logos-electromechanical/Zigduino-Hardware/README.md

Zigduino-Hardware
=================

Hardware repository for the Zigduino
