logos-electromechanical/Zigduino-Hardware/Micro/doc/zigduinomote-layout.png

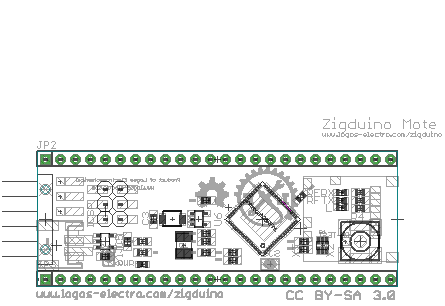
Micro/doc/zigduinomote-layout.png
