logos-electromechanical/Zigduino-Hardware/Micro/doc/zigduinomote-schematic.png

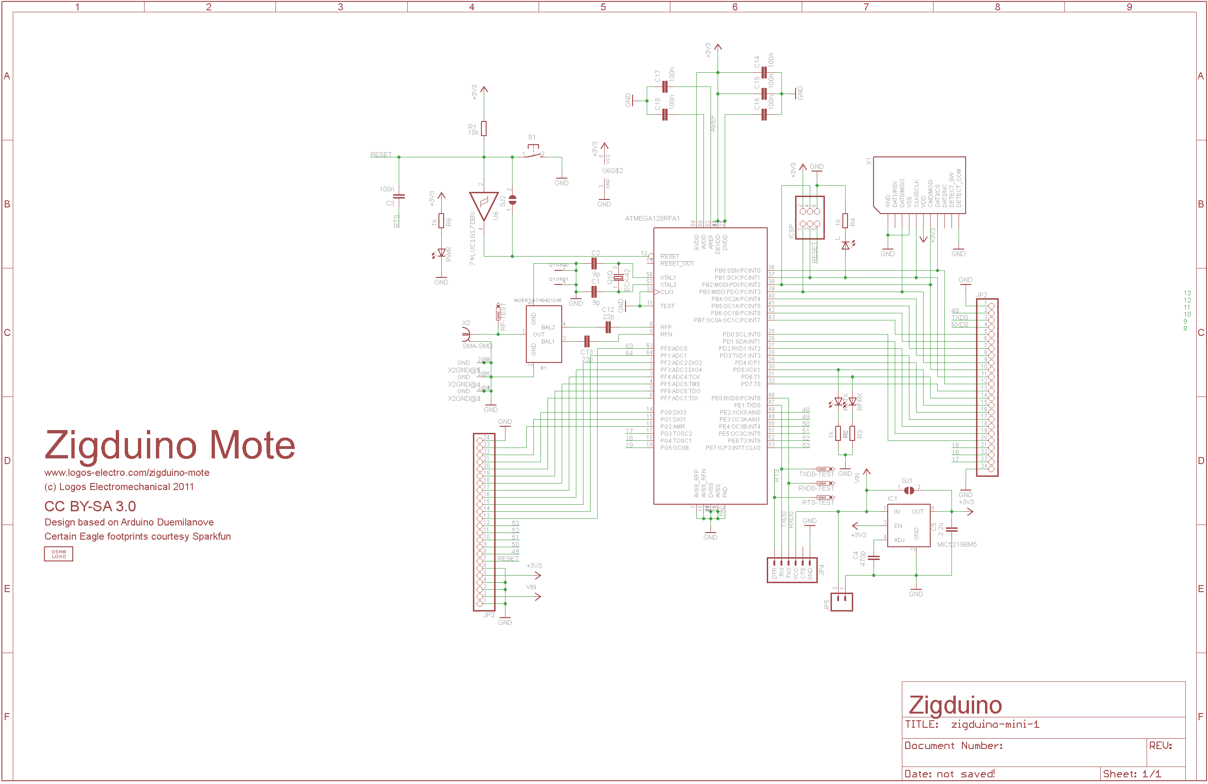
Micro/doc/zigduinomote-schematic.png
