logos-electromechanical/Zigduino-Hardware/Micro/zig-micro-bottom.png

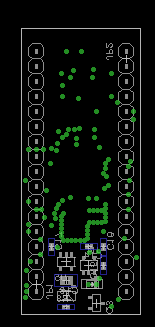
Micro/zig-micro-bottom.png
