logos-electromechanical/Zigduino-Hardware/Micro/zig-micro-schematic.png

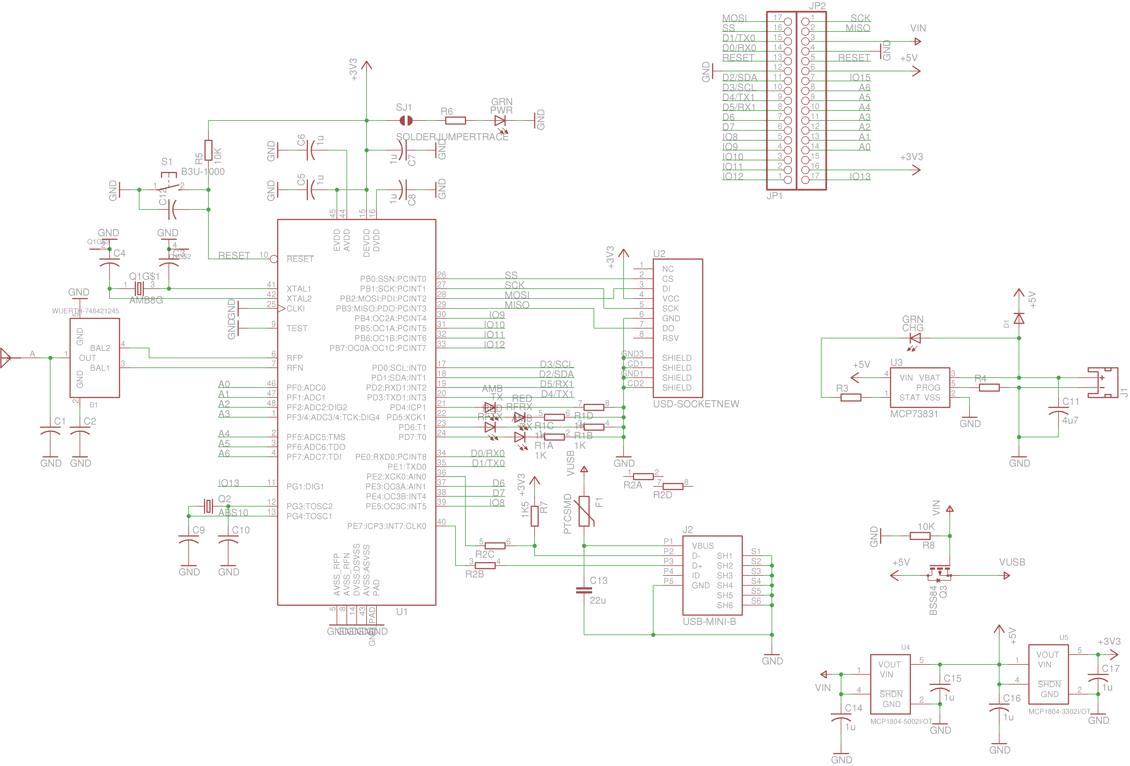
Micro/zig-micro-schematic.png
