logos-electromechanical/Zigduino-Hardware/Micro/zig-micro-top.png

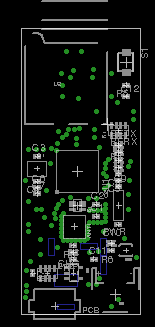
Micro/zig-micro-top.png
