logos-electromechanical/Zigduino-Hardware/Main/mfg/BoM/zigduino-v5_2011Aug-Build-Parts.xlsx

Sheet: Zigduino-v5 individual
Manufacturer Part Number | Description | Quantity Min | Part References | Populate?
742C083101JPTR | RES ARRAY 100 OHM 8TERM 4RES SMD | 6 | R12/R13/R14/R15/R16/R17 | Y
961206-6404-AR | CONN HEADER VERT DUAL 6POS GOLD | 1 | ICSP | DNP
1734035-2 | CONN MINI USB RCPT RA TYPE B SMD | 1 | USB | Y
748421245 | BALUN EMBER351 & 357 0805 SMD | 1 | B1 | Y
ATMEGA128RFA1-ZUR | IC AVR MCU 2.4GHZ XCEIVER 64QFN | 1 | U3 | Y
B3U-1000P | SWITCH TACT SPST W/O GND SMD | 1 | S1 | Y
B150B-13-F | DIODE SCHOTTKY 50V 1A SMB | 1 | D1 | Y
C1608C0G1H090C | CAP CER 9.0PF 50V C0G 0603 | 2 | C1/C2 | Y
C3216Y5V1H475Z | CAP CER 4.7UF 50V Y5V 1206 | 3 | C4/C5/C6 | Y
CC0603MRY5V9BB104 | CAP CERAMIC .1UF 50V Y5V 0603 | 11 | C3/C7/C8/C9/C10/C11/C14/C15/C16/C17/C18 | Y
CONREVSMA003.062 | RF Connectors RP-SMA Fml Edge Mnt for 0.062 Thick Brd | 1 | RF | DNP
ECS-160-9-42-CKM-TR | CRYSTAL 16.000 MHZ 9PF SMD | 1 | Q1 | Y
NTF5P03T3G | MOSFET P-CH 30V 3.7A SOT223 | 1 | T1 | Y
FT232RL-REEL | IC USB TO SERIAL UART 28-SSOP | 1 | U4 | Y
GQM1885C1H220JB01D | CAP CER 22PF 50V 5% C0G 0603 | 2 | C12/C13 | Y
LM358DR | IC OPAMP GP 700KHZ DUAL 8SOIC | 1 | U5 | Y
LTST-C193KGKT-5A | LED GREEN RECT CLEAR 0603 | 2 | L/PWR | Y
LTST-C193KRKT-5A | LED RED RECT CLEAR 0603 | 4 | RFRX/RFTX/RX/TX | Y
MIC2954-03WS-TR | IC REG LDO 250MA 5V 1.0% SOT223 | 1 | U1 | Y
MIC5201-3.3YS TR | IC REG LDO 200MA 3.3V 1% SOT223 | 1 | U2 | Y
MINISMDC050F-2 | POLYSWITCH .50A RESET FUSE SMD | 1 | F1 | Y
PJ-002AH | CONN POWER JACK 2.1X5.5MM HI CUR | 1 | DC-PWR | DNP
PPPC021LFBN | CONN HEADER FEMALE 2POS .1" GOLD | 1 | I2C | DNP
PPPC081LFBN | CONN HEADER FEM 8POS .1" SGL GLD | 2 | DIGITAL0/DIGITAL1 | DNP
PPTC031LFBN | CONN HEADER FEM 3POS .1" SGL GLD | 1 | SPI | DNP
PPTC061LFBN | CONN HEADER FEM 6POS .1" SGL GLD | 2 | ANALOG/POWER | DNP
RMCF0603FT1K00 | RES 1K OHM 1/10W 1% 0603 SMD | 6 | R4/R5/R6/R7/R8/R9 | Y
RMCF0603FT10K0 | RES 10K OHM 1/10W 1% 0603 SMD | 3 | R1/R10/R11 | Y
RMCF0603FT100R | RES 100 OHM 1/10W 1% 0603 SMD | 1 | R2 | DNP
SD103ASDM-7 | DIODE SCHOTTKY ARRAY 40V SOT26 | 12 | D2/D3/D4/D5/D6/D7/D8/D9/D10/D11/D12/D13 | Y
SN74LVC1G17DBVR | IC BUFFER SCHMIT TRIG SOT235 | 1 | U6 | Y

Sheet: Zigduino-v5b parts order
Board Quantity
300
Manufacturer Part Number | Description | Quantity Min | Unit Price | Total
742C083101JPTR | RES ARRAY 100 OHM 8TERM 4RES SMD | 5000 | $0.0080 | $40.00
961206-6404-AR | CONN HEADER VERT DUAL 6POS GOLD | 315 | $0.1980 | $62.37
1734035-2 | CONN MINI USB RCPT RA TYPE B SMD | 315 | $0.6990 | $220.18
748421245 | BALUN EMBER351 & 357 0805 SMD | 315 | $1.6125 | $507.94
ATMEGA128RFA1-ZUR | IC AVR MCU 2.4GHZ XCEIVER 64QFN | 315 | $5.2800 | $1663.20
B3U-1000P | SWITCH TACT SPST W/O GND SMD | 315 | $0.6100 | $192.15
B150B-13-F | DIODE SCHOTTKY 50V 1A SMB | 315 | $0.4420 | $139.23
C1608C0G1H090C | CAP CER 9.0PF 50V C0G 0603 | 4000 | $0.0080 | $32.00
C3216Y5V1H475Z | CAP CER 4.7UF 50V Y5V 1206 | 2000 | $0.0530 | $106.00
CC0603MRY5V9BB104 | CAP CERAMIC .1UF 50V Y5V 0603 | 4000 | $0.0040 | $16.00
CONREVSMA003.062 | RF Connectors RP-SMA Fml Edge Mnt for 0.062 Thick Brd | 300 | $2.8586 | $857.58
ECS-160-9-42-CKM-TR | CRYSTAL 16.000 MHZ 9PF SMD | 315 | $1.2375 | $389.81
NTF5P03T3G | MOSFET P-CH 30V 3.7A SOT223 | 315 | $0.4680 | $147.42
FT232RL-REEL | IC USB TO SERIAL UART 28-SSOP | 315 | $3.2500 | $1023.75
GQM1885C1H220JB01D | CAP CER 22PF 50V 5% C0G 0603 | 630 | $0.3360 | $211.68
LM358DR | IC OPAMP GP 700KHZ DUAL 8SOIC | 315 | $0.2010 | $63.32
LTST-C193KGKT-5A | LED GREEN RECT CLEAR 0603 | 630 | $0.0630 | $39.69
LTST-C193KRKT-5A | LED RED RECT CLEAR 0603 | 1260 | $0.0590 | $74.34
MIC2954-03WS-TR | IC REG LDO 250MA 5V 1.0% SOT223 | 315 | $0.8960 | $282.24
MCP1703-3302E/DB | IC REG LDO 3.3V 250MA SOT-223-3 | 315 | $0.4700 | $148.05
MINISMDC050F-2 | POLYSWITCH .50A RESET FUSE SMD | 315 | $0.3100 | $97.65
PJ-002AH | CONN POWER JACK 2.1X5.5MM HI CUR | 350 | $0.7470 | $261.45
PPPC021LFBN | CONN HEADER FEMALE 2POS .1" GOLD | 315 | $0.1721 | $54.21
PPPC081LFBN | CONN HEADER FEM 8POS .1" SGL GLD | 630 | $0.3117 | $196.40
PPTC031LFBN | CONN HEADER FEM 3POS .1" SGL GLD | 315 | $0.2220 | $69.93
PPTC061LFBN | CONN HEADER FEM 6POS .1" SGL GLD | 630 | $0.2417 | $152.26 | $2314.20
RMCF0603FT1K00 | RES 1K OHM 1/10W 1% 0603 SMD | 5000 | $0.0023 | $11.40
RMCF0603FT10K0 | RES 10K OHM 1/10W 1% 0603 SMD | 5000 | $0.0023 | $11.40
W1030 | ANTENNA 2.4GHZ R-SMA BLACK 3" | 300 | $2.2000 | $660.00 | $1249.68
SD103ASDM-7 | DIODE SCHOTTKY ARRAY 40V SOT26 | 6000 | $0.1305 | $783.00
SN74LVC1G17DBVR | IC BUFFER SCHMIT TRIG SOT235 | 315 | $0.1606 | $50.60
 |  |  | $28.5508 | $8565.25 | $6251.06 | $5001.38
 |  |  | $2.1667 | $650.00

Sheet: Zigduino-v5 parts order
Board Quantity
60
Manufacturer Part Number | Manufacturer Name | Digikey Part Number | Description | Quantity Min | Part References | Populate?
742C083101JPTR | CTS Resistor Products |  | RES ARRAY 100 OHM 8TERM 4RES SMD | 5000 | R12/R13/R14/R15/R16/R17 | Y
961206-6404-AR | 3M |  | CONN HEADER VERT DUAL 6POS GOLD | 63 | ICSP | DNP
1734035-2 | Tyco Electronics | A31727DKR-ND | CONN MINI USB RCPT RA TYPE B SMD | 63 | USB | Y
748421245 | Wurth Electronics Inc | 732-2230-6-ND | BALUN EMBER351 & 357 0805 SMD | 63 | B1 | Y
ATMEGA128RFA1-ZUR | Atmel | ATMEGA128RFA1-ZU-ND | IC AVR MCU 2.4GHZ XCEIVER 64QFN | 63 | U3 | Y
B3U-1000P | Omron Electronics Inc - ECB Div | SW1020DKR-ND | SWITCH TACT SPST W/O GND SMD | 63 | S1 | Y
B150B-13-F | Diodes Inc | B150B-FDIDKR-ND | DIODE SCHOTTKY 50V 1A SMB | 63 | D1 | Y
C1608C0G1H090C | TDK Corporation | 445-5046-2-ND | CAP CER 9.0PF 50V C0G 0603 | 126 | C1/C2 | Y
C3216Y5V1H475Z | TDK Corporation |  | CAP CER 4.7UF 50V Y5V 1206 | 2000 | C4/C5/C6 | Y
CC0603MRY5V9BB104 | Yageo |  | CAP CERAMIC .1UF 50V Y5V 0603 | 4000 | C3/C7/C8/C9/C10/C11/C14/C15/C16/C17/C18 | Y
CONREVSMA003.062 | Connector City |  | RF Connectors RP-SMA Fml Edge Mnt for 0.062 Thick Brd | 63 | RF | DNP
ECS-160-9-42-CKM-TR | ECS Inc | XC1611DKR-ND | CRYSTAL 16.000 MHZ 9PF SMD | 63 | Q1 | Y
NTF5P03T3G | ON Semi | NTF5P03T3GOSCT-ND | MOSFET P-CH 30V 3.7A SOT223 | 63 | T1 | Y
FT232RL-REEL | FTDI | 768-1007-6-ND | IC USB TO SERIAL UART 28-SSOP | 63 | U4 | Y
GQM1885C1H220JB01D | Murata Electronics | 490-3575-2-ND | CAP CER 22PF 50V 5% C0G 0603 | 126 | C12/C13 | Y
LM358DR | Texas Instruments | 296-1014-6-ND | IC OPAMP GP 700KHZ DUAL 8SOIC | 63 | U5 | Y
LTST-C193KGKT-5A | Lite-On Inc | 160-1828-6-ND | LED GREEN RECT CLEAR 0603 | 126 | L/PWR | Y
LTST-C193KRKT-5A | Lite-On Inc | 160-1830-6-ND | LED RED RECT CLEAR 0603 | 252 | RFRX/RFTX/RX/TX | Y
MIC2954-03WS-TR | Micrel Inc | 576-1154-6-ND | IC REG LDO 250MA 5V 1.0% SOT223 | 63 | U1 | Y
MIC5201-3.3YS TR | Micrel Inc | 576-1251-6-ND | IC REG LDO 200MA 3.3V 1% SOT223 | 63 | U2 | Y
MINISMDC050F-2 | PolySwitch | MINISMDC050FDKR-ND | POLYSWITCH .50A RESET FUSE SMD | 63 | F1 | Y
PJ-002AH | CUI Inc |  | CONN POWER JACK 2.1X5.5MM HI CUR | 63 | DC-PWR | DNP
PPPC021LFBN | Sullins Connector Solutions |  | CONN HEADER FEMALE 2POS .1" GOLD | 63 | I2C | DNP
PPPC081LFBN | Sullins Connector Solutions |  | CONN HEADER FEM 8POS .1" SGL GLD | 126 | DIGITAL0/DIGITAL1 | DNP
PPTC031LFBN | Sullins Connector Solutions |  | CONN HEADER FEM 3POS .1" SGL GLD | 63 | SPI | DNP
PPTC061LFBN | Sullins Connector Solutions |  | CONN HEADER FEM 6POS .1" SGL GLD | 126 | ANALOG/POWER | DNP
RMCF0603FT1K00 | Stackpole Electronics Inc |  | RES 1K OHM 1/10W 1% 0603 SMD | 5000 | R4/R5/R6/R7/R8/R9 | Y
RMCF0603FT10K0 | Stackpole Electronics Inc | RMCF0603FT10K0TR-ND | RES 10K OHM 1/10W 1% 0603 SMD | 5000 | R1/R10/R11 | Y
RMCF0603FT100R | Stackpole Electronics Inc |  | RES 100 OHM 1/10W 1% 0603 SMD | 5000 | R2 | DNP
SD103ASDM-7 | Diodes Inc |  | DIODE SCHOTTKY ARRAY 40V SOT26 | 3000 | D2/D3/D4/D5/D6/D7/D8/D9/D10/D11/D12/D13 | Y
SN74LVC1G17DBVR | Texas Instruments | 296-11933-6-ND | IC BUFFER SCHMIT TRIG SOT235 | 63 | U6 | Y
