logos-electromechanical/Zigduino-Hardware/Main/zigduino-r3a.brd

## EAGLE design Main/zigduino-r3a.brd (2013-12-27)

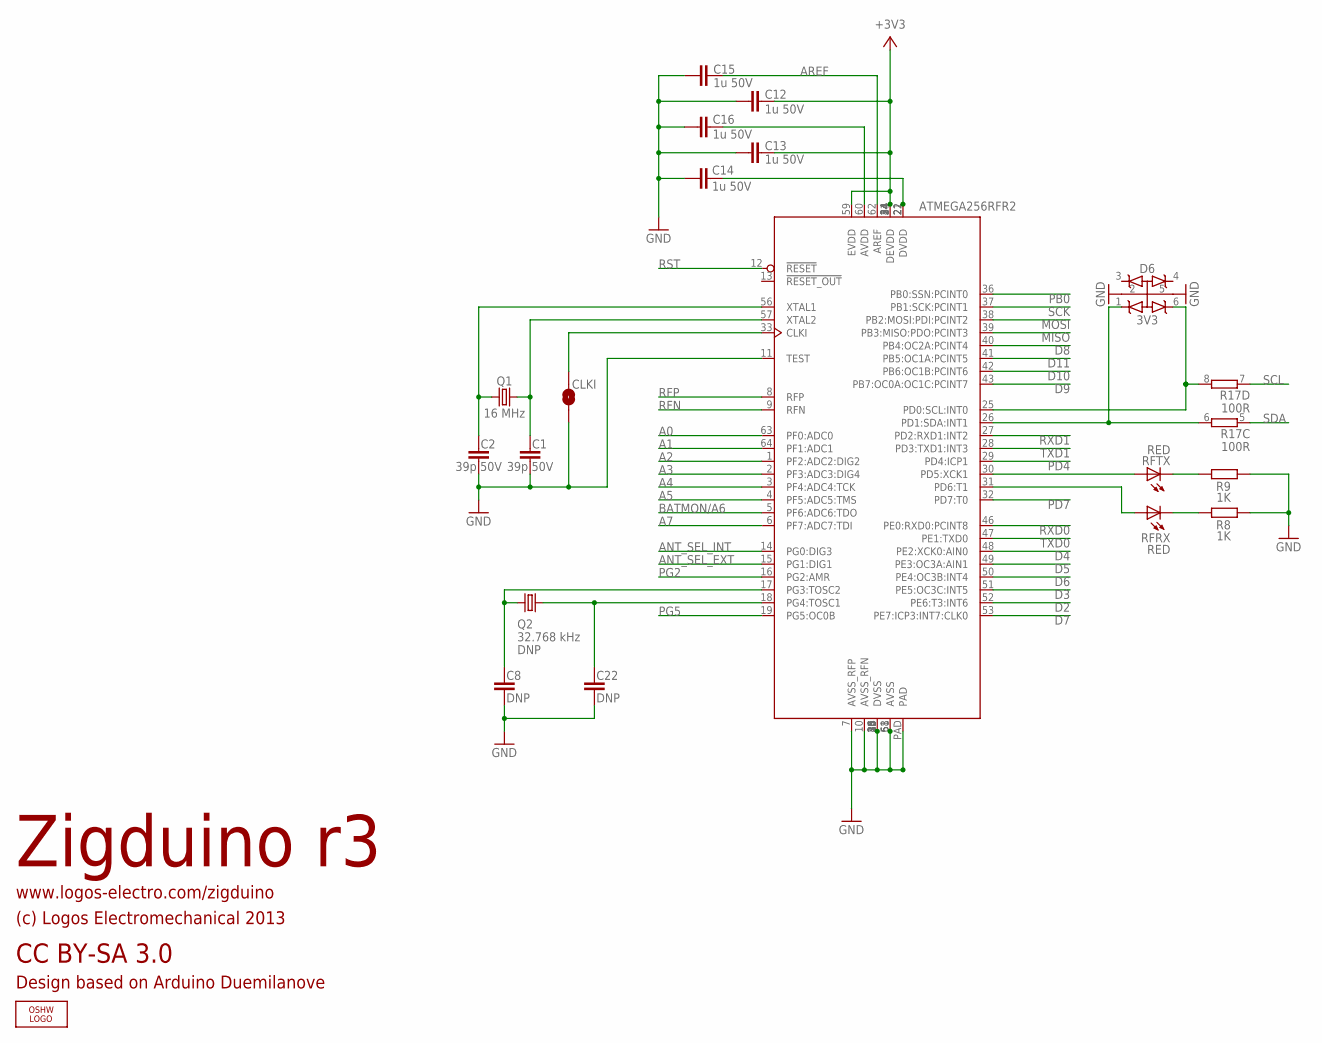
[picture p7: schematic zigduino-r3a.sch, sheet 1]

Parts:
C1, C2: 39p 50V; C0603; PARTNO C1608C0G1H390J
C8, C22: DNP; C0603
C12, C13, C14, C15, C16: 1u 50V; C0603
CLKI: SOLDERJUMPERTRACE; SJ_2S-TRACE
D6: 3V3; SC74_INFINEON
LOGO1: OSHW_LOGO_FILLX0200-NT; OSHW_FILLX200_NOTEXT
Q1: 16 MHz; CSM-3X; PARTNO ECS-160-20-3X-TR
Q2: 32.768 kHz; TC26H
R8, R9: 1K; R0603; PARTNO RMCF0603FT1K00
R17: 100R; CTS742C083-RES; PARTNO 742C083101JPTR
RFRX: RED; CHIP-LED0603; PARTNO LTST-C193KRKT-5A
RFTX: RED; CHIP-LED0603; PARTNO LTST-C193KRKT-5A
U3: ATMEGA128RFA1; QFN64; PARTNO ATMEGA128RFA1-ZUR

Connections:
+3V3: C12.1, C13.1, U3.23 (DEVDD), U3.34 (DEVDD), U3.44 (DEVDD), U3.54 (DEVDD), U3.59 (EVDD); also elsewhere on the board
A0: U3.63 (PF0:ADC0); also elsewhere on the board
A1: U3.64 (PF1:ADC1); also elsewhere on the board
A2: U3.1 (PF2:ADC2:DIG2); also elsewhere on the board
A3: U3.2 (PF3:ADC3:DIG4); also elsewhere on the board
A4: U3.3 (PF4:ADC4:TCK); also elsewhere on the board
A5: U3.4 (PF5:ADC5:TMS); also elsewhere on the board
A7: U3.6 (PF7:ADC7:TDI); also elsewhere on the board
ANT_SEL_EXT: U3.15 (PG1:DIG1); also elsewhere on the board
ANT_SEL_INT: U3.14 (PG0:DIG3); also elsewhere on the board
AREF: C15.2, U3.62 (AREF); also elsewhere on the board
BATMON/A6: U3.5 (PF6:ADC6:TDO); also elsewhere on the board
D2: U3.52 (PE6:T3:INT6); also elsewhere on the board
D3: U3.51 (PE5:OC3C:INT5); also elsewhere on the board
D4: U3.48 (PE2:XCK0:AIN0); also elsewhere on the board
D5: U3.49 (PE3:OC3A:AIN1); also elsewhere on the board
D6: U3.50 (PE4:OC3B:INT4); also elsewhere on the board
D7: U3.53 (PE7:ICP3:INT7:CLK0); also elsewhere on the board
D8: U3.40 (PB4:OC2A:PCINT4); also elsewhere on the board
D9: U3.43 (PB7:OC0A:OC1C:PCINT7); also elsewhere on the board
D10: U3.42 (PB6:OC1B:PCINT6); also elsewhere on the board
D11: U3.41 (PB5:OC1A:PCINT5); also elsewhere on the board
GND: C1.1, C2.1, C8.1, C12.2, C13.2, C14.2, C15.1, C16.1, C22.1, CLKI.2, D6.2 (G2), D6.5 (G5), R8.1, R9.1, U3.7 (AVSS_RFP), U3.10 (AVSS_RFN), U3.11 (TEST), U3.20 (DVSS), U3.24 (DVSS), U3.35 (DVSS), U3.45 (DVSS), U3.55 (DVSS), U3.58 (AVSS), U3.61 (AVSS), U3.PAD; also elsewhere on the board
MISO: U3.39 (PB3:MISO:PDO:PCINT3); also elsewhere on the board
MOSI: U3.38 (PB2:MOSI:PDI:PCINT2); also elsewhere on the board
unnamed: R9.2, RFTX.C
unnamed: C1.2, Q1.1, U3.57 (XTAL2)
unnamed: C2.2, Q1.2, U3.56 (XTAL1)
unnamed: D6.6 (Z6), R17.8 (2), U3.25 (PD0:SCL:INT0)
unnamed: D6.1 (Z1), R17.6 (2), U3.26 (PD1:SDA:INT1)
unnamed: R8.2, RFRX.C
unnamed: CLKI.1, U3.33 (CLKI)
unnamed: C14.1, U3.21 (DVDD), U3.22 (DVDD)
unnamed: C16.2, U3.60 (AVDD)
unnamed: C8.2, Q2.2, U3.17 (PG3:TOSC2)
unnamed: C22.2, Q2.1, U3.18 (PG4:TOSC1)
PB0: U3.36 (PB0:SSN:PCINT0); also elsewhere on the board
PD4: U3.29 (PD4:ICP1); also elsewhere on the board
PD7: U3.32 (PD7:T0); also elsewhere on the board
PG2: U3.16 (PG2:AMR); also elsewhere on the board
PG5: U3.19 (PG5:OC0B); also elsewhere on the board
RFN: U3.9 (RFN); also elsewhere on the board
RFP: U3.8 (RFP); also elsewhere on the board
RFRX: RFRX.A, U3.31 (PD6:T1)
RFTX: RFTX.A, U3.30 (PD5:XCK1)
RST: U3.12 (!RESET!); also elsewhere on the board
RXD0: U3.46 (PE0:RXD0:PCINT8); also elsewhere on the board
RXD1: U3.27 (PD2:RXD1:INT2); also elsewhere on the board
SCK: U3.37 (PB1:SCK:PCINT1); also elsewhere on the board
SCL: R17.7 (1); also elsewhere on the board
SDA: R17.5 (1); also elsewhere on the board
TXD0: U3.47 (PE1:TXD0); also elsewhere on the board
TXD1: U3.28 (PD3:TXD1:INT3); also elsewhere on the board

Notes on the sheet:
Zigduino r3
CC BY-SA 3.0
(c) Logos Electromechanical 2013
www.logos-electro.com/zigduino
ATMEGA256RFR2
Design based on Arduino Duemilanove
DNP

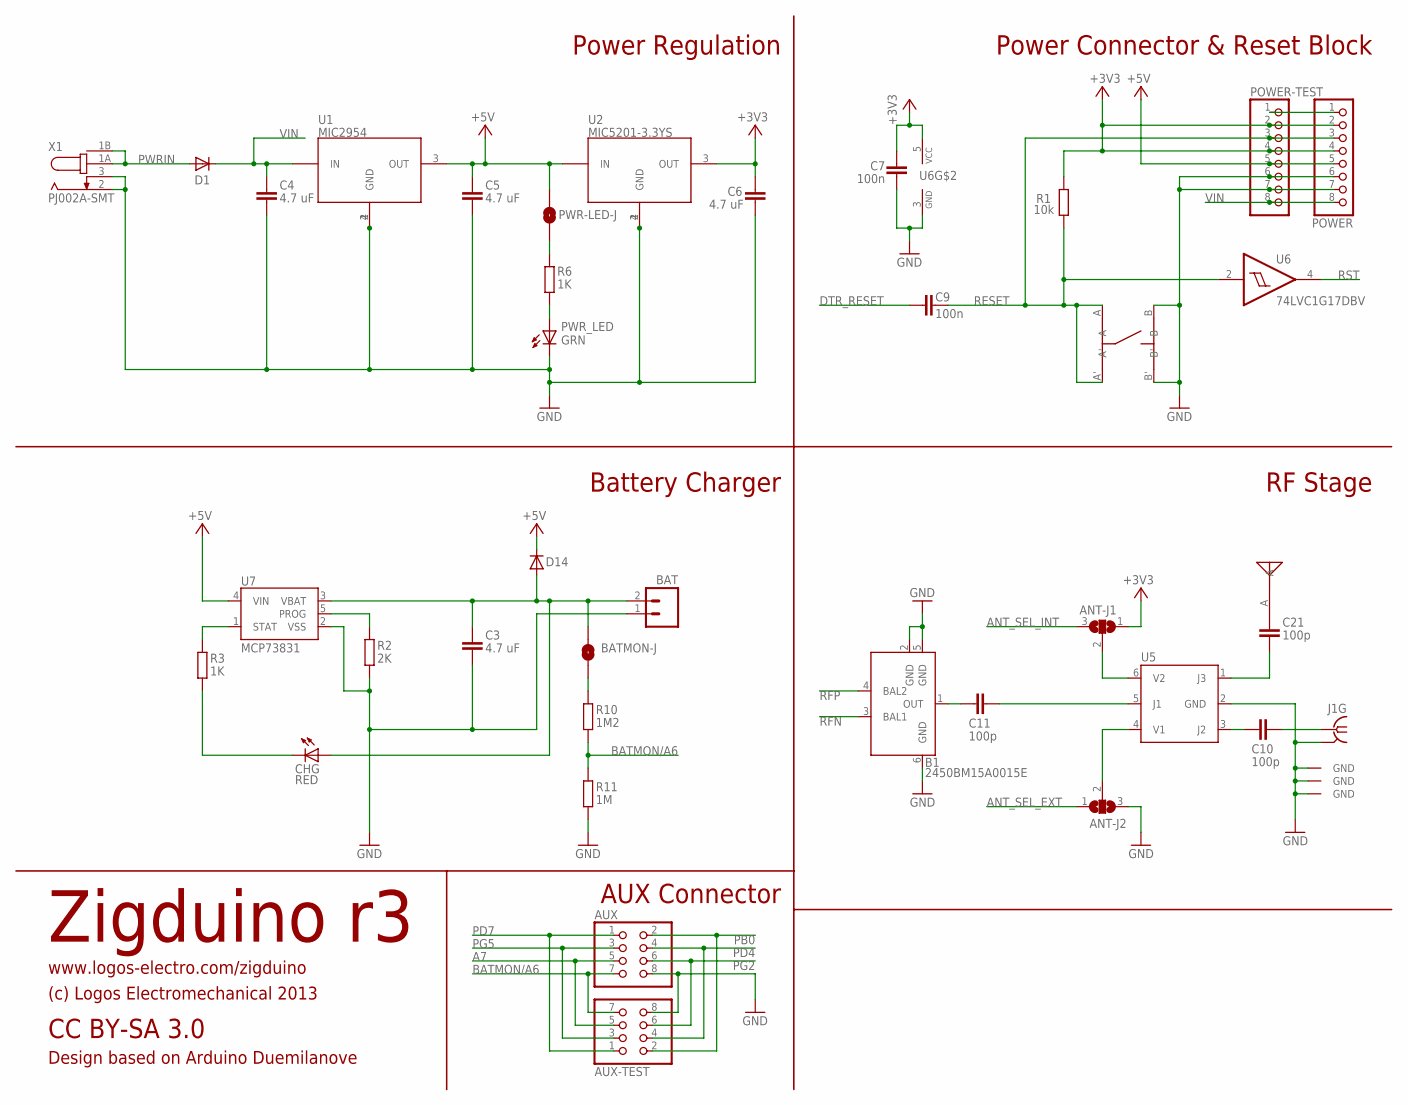
[picture p8: schematic zigduino-r3a.sch, sheet 2]

Parts:
ANT1: MOLEX-ANT; PARTNO 0479480001
ANT-J1: SOLDERJUMPER_2WAYSHORT1&2; SJ_3_SHORT1&2
ANT-J2: SOLDERJUMPER_2WAYSHORT2&3; SJ_3_SHORT2&3
AUX: PINHD-2X4_2.54-SMD; 2X04SMD
AUX-TEST: PINHD-2X4TEST; 2X04-TEST
B1: 2450BM15A0015E; WURTH-BALUN
BAT: M02-JST-2MM-SMT; S2B-PH; PARTNO S2B-PH-SM4-TB(LF)(SN)
BATMON-J: SOLDERJUMPERTRACE; SJ_2S-TRACE
C3, C4, C5, C6: 4.7 uF; C1206; PARTNO C3216Y5V1H475Z
C7, C9: 100n; C0603; PARTNO CC0603MRY5V9BB104
C10, C11, C21: 100p; C0603
CHG: RED; CHIP-LED0603; PARTNO LTST-C193KRKT-5A
D1, D14: DIODESOD-123; SOD-123; PARTNO B150B-13-F
J1: CONNREVSMA003.062; EDGE-RSMA
POWER: PINHD-1X8_2.54-SMD; 1X08SMD; PARTNO 19743
POWER-TEST: PINHD-1X8TEST; 1X08-TEST
PWR-LED-J: SOLDERJUMPERTRACE; SJ_2S-TRACE
PWR_LED: GRN; CHIP-LED0603; PARTNO LTST-C193KGKT-5A
R1: 10k; R0603; PARTNO RMCF0603FT10K0
R2: 2K; R0603; PARTNO RC0603FR-072KL
R3, R6: 1K; R0603; PARTNO RMCF0603FT1K00
R10: 1M2; R0603; PARTNO ERJ-3EKF1204V
R11: 1M; R0603; PARTNO ERJ-3EKF1004V
SW1: EVQ-PSD02K; EVQPSD02K; PARTNO EVQ-PSD02K
U1: MIC2954; SOT223; PARTNO MIC2954-03WS-TR
U2: MIC5201-3.3YS; SOT223; PARTNO MIC5201-3.3YS TR
U5: AS222-92LF; SC70-6L
U6: 74LVC1G17DBV; SOT23-5; PARTNO SN74LVC1G17DBVR
U7: MCP73831; SOT23-5; PARTNO MCP73831T-2ACI/OT
X1: PJ002A-SMT; PARTNO PJ-002AH-SMT

Connections:
+3V3: ANT-J1.1, C6.1, C7.2, POWER.2, POWER.4, POWER-TEST.2, POWER-TEST.4, R1.2, U2.3 (OUT), U6.5 (VCC); also elsewhere on the board
+5V: C5.1, D14.C, POWER.5, POWER-TEST.5, PWR-LED-J.2, U1.3 (OUT), U2.1 (IN), U7.4 (VIN); also elsewhere on the board
A7: AUX.5, AUX-TEST.5; also elsewhere on the board
ANT_SEL_EXT: ANT-J2.1; also elsewhere on the board
ANT_SEL_INT: ANT-J1.3; also elsewhere on the board
BATMON/A6: AUX.7, AUX-TEST.7, R10.2, R11.1; also elsewhere on the board
DTR_RESET: C9.1; also elsewhere on the board
GND: ANT-J2.3, AUX.8, AUX-TEST.8, B1.2 (GND), B1.5 (GND), B1.6 (GND), BAT.1, C3.2, C4.2, C5.2, C6.2, C7.1, J1.SHIELD@0 (GND), J1.SHIELD@1 (GND), J1.SHIELD@2 (GND), J1.SHIELD@3 (GND), POWER.6, POWER.7, POWER-TEST.6, POWER-TEST.7, PWR_LED.C, R2.1, R11.2, SW1.B, SW1.B', U1.2 (GND), U1.4 (GND), U2.2 (GND), U2.4 (GND), U5.2 (GND), U6.3 (GND), U7.2 (VSS), X1.2, X1.3; also elsewhere on the board
unnamed: PWR_LED.A, R6.2
unnamed: PWR-LED-J.1, R6.1
unnamed: BATMON-J.1, R10.1
unnamed: B1.1 (OUT), C11.2
unnamed: C11.1, U5.5 (J1)
unnamed: C10.2, U5.3 (J2)
unnamed: R2.2, U7.5 (PROG)
unnamed: R3.1, U7.1 (STAT)
unnamed: CHG.C, R3.2
unnamed: C21.2, U5.1 (J3)
unnamed: C10.1, J1.CENTER (1)
unnamed: POWER.1, POWER-TEST.1
unnamed: ANT1.A, C21.1
unnamed: ANT-J2.2, U5.4 (V1)
unnamed: ANT-J1.2, U5.6 (V2)
PB0: AUX.2, AUX-TEST.2; also elsewhere on the board
PD4: AUX.4, AUX-TEST.4; also elsewhere on the board
PD7: AUX.1, AUX-TEST.1; also elsewhere on the board
PG2: AUX.6, AUX-TEST.6; also elsewhere on the board
PG5: AUX.3, AUX-TEST.3; also elsewhere on the board
PWRIN: D1.A, X1.1A, X1.1B
RESET: C9.2, POWER.3, POWER-TEST.3, R1.1, SW1.A, SW1.A', U6.2 (I); also elsewhere on the board
RFN: B1.3 (BAL1); also elsewhere on the board
RFP: B1.4 (BAL2); also elsewhere on the board
RST: U6.4 (O); also elsewhere on the board
VBAT: BAT.2, BATMON-J.2, C3.1, CHG.A, D14.A, U7.3 (VBAT); also elsewhere on the board
VIN: C4.1, D1.C, POWER.8, POWER-TEST.8, U1.1 (IN)

Notes on the sheet:
Zigduino r3
CC BY-SA 3.0
(c) Logos Electromechanical 2013
www.logos-electro.com/zigduino
Design based on Arduino Duemilanove
AUX Connector
Battery Charger
Power Regulation
RF Stage
Power Connector & Reset Block

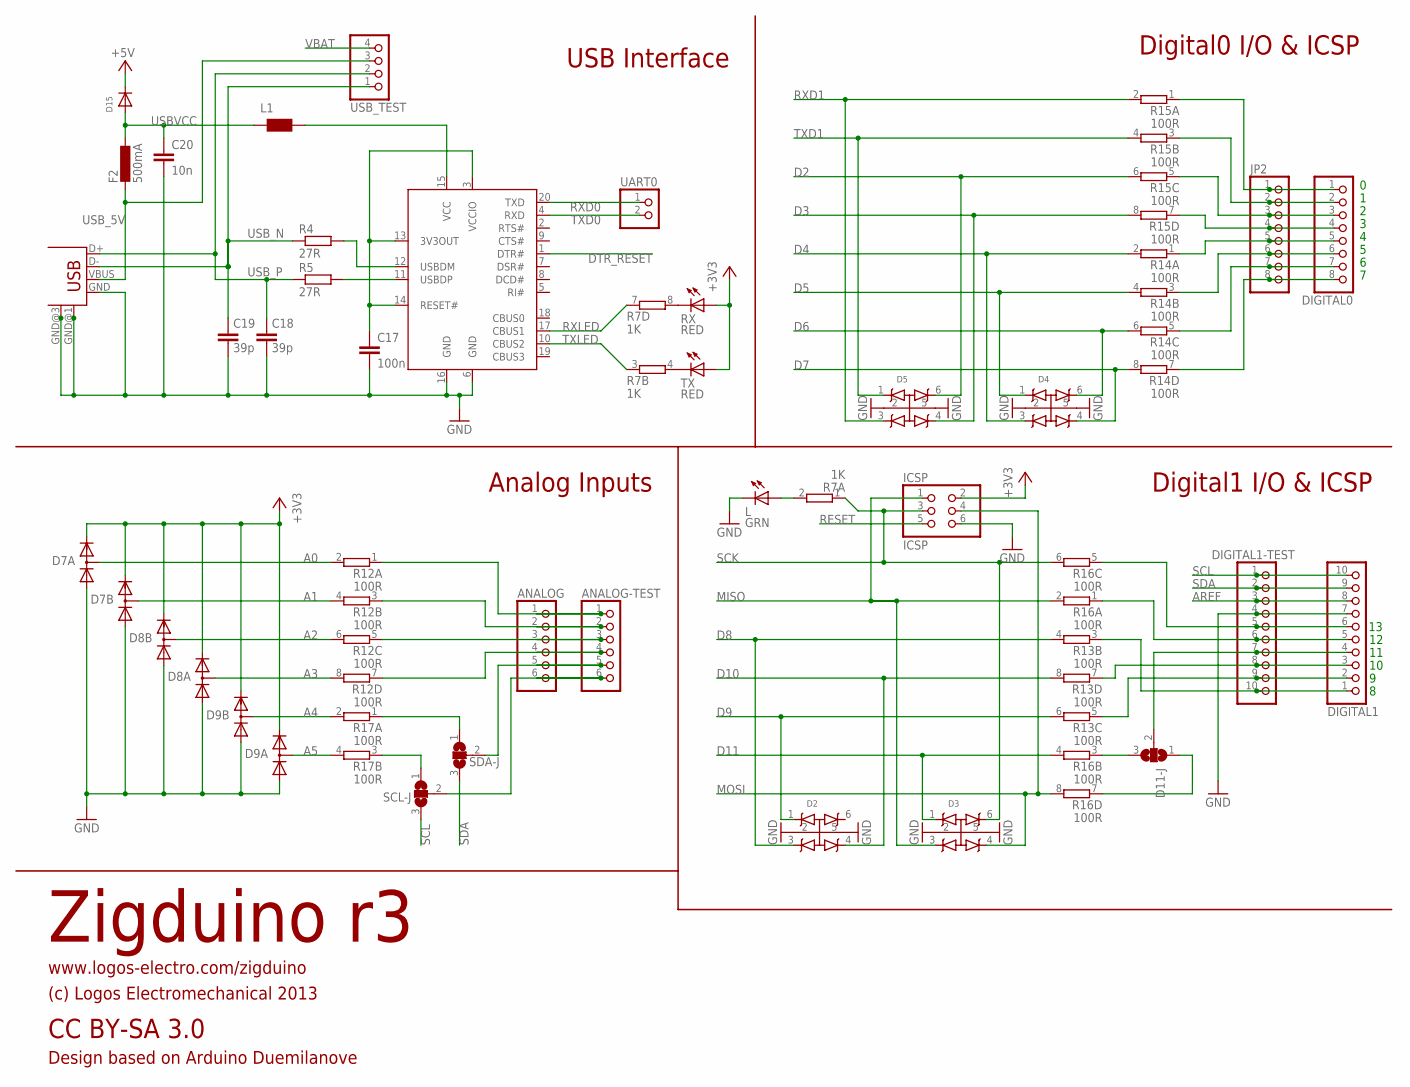
[picture p9: schematic zigduino-r3a.sch, sheet 3]

Parts:
ANALOG: PINHD-1X6_2.54-SMD; 1X06SMD; PARTNO 19742
ANALOG-TEST: PINHD-1X6TEST; 1X06-TEST
C17: 100n; C0603; PARTNO CC0603MRY5V9BB104
C18, C19: 39p; C0603; PARTNO C1608C0G1H390J
C20: 10n; C0603; PARTNO GRM188R71H103KA01D
D2, D3, D4, D5: PESD3V3S4UD; SC74_INFINEON
D7, D8, D9: SD103ASDM; SOT26; PARTNO SD103ASDM-7
D11-J: SOLDERJUMPER_2WAYSHORT2&3; SJ_3_SHORT2&3
D15: DIODESOD-123; SOD-123; PARTNO B150B-13-F
DIGITAL0: PINHD-1X8_2.54-SMD; 1X08SMD; PARTNO 19743
DIGITAL1: PINHD-1X10_2.54-SMD; 1X10SMD; PARTNO 20083
DIGITAL1-TEST: PINHD-1X10TEST; 1X10-TEST
F2: 500mA; L1812; PARTNO MF-MSMF050-2
ICSP: ICSP; 2X03; PARTNO 961206-6404-AR
JP2: PINHD-1X8TEST; 1X08-TEST
L: GRN; CHIP-LED0603; PARTNO LTST-C193KGKT-5A
L1: WE-CBF_0805; 0805; PARTNO MI0805K400R-10
R4, R5: 27R; R0603; PARTNO RC0603JR-0727RL
R7: 1K; CTS742C083-RES; PARTNO 742C083102JPTR
R12, R13, R14, R15, R16, R17: 100R; CTS742C083-RES; PARTNO 742C083101JPTR
RX: RED; CHIP-LED0603; PARTNO LTST-C193KRKT-5A
SCL-J: SOLDERJUMPER_2WAYSHORT2&3; SJ_3_SHORT2&3
SDA-J: SOLDERJUMPER_2WAYSHORT2&3; SJ_3_SHORT2&3
TX: RED; CHIP-LED0603; PARTNO LTST-C193KRKT-5A
U4: FT231XS-R; SSOP20; PARTNO FT231XS-R
UART0: PINHD-1X2; 1X02; PARTNO 00522
USB: USB-MB-S; PARTNO 20236
USB_TEST: PINHD-1X4TEST; 1X04-TEST

Connections:
+3V3: D7.2 (C), D7.5 (C), D8.2 (C), D8.5 (C), D9.2 (C), D9.5 (C), ICSP.2, RX.A, TX.A; also elsewhere on the board
+5V: D15.C; also elsewhere on the board
A0: D7.4 (AC), R12.2; also elsewhere on the board
A1: D7.1 (AC), R12.4 (2); also elsewhere on the board
A2: D8.1 (AC), R12.6 (2); also elsewhere on the board
A3: D8.4 (AC), R12.8 (2); also elsewhere on the board
A4: D9.1 (AC), R17.2; also elsewhere on the board
A5: D9.4 (AC), R17.4 (2); also elsewhere on the board
AREF: DIGITAL1.8, DIGITAL1-TEST.3; also elsewhere on the board
D2: D5.6 (Z6), R15.6 (2); also elsewhere on the board
D3: D5.4 (Z4), R15.8 (2); also elsewhere on the board
D4: D4.3 (Z3), R14.2; also elsewhere on the board
D5: D4.1 (Z1), R14.4 (2); also elsewhere on the board
D6: D4.6 (Z6), R14.6 (2); also elsewhere on the board
D7: D4.4 (Z4), R14.8 (2); also elsewhere on the board
D8: D2.3 (Z3), R13.4 (2); also elsewhere on the board
D9: D2.1 (Z1), R13.6 (2); also elsewhere on the board
D10: D2.4 (Z4), R13.8 (2); also elsewhere on the board
D11: D3.1 (Z1), R16.4 (2); also elsewhere on the board
DTR_RESET: U4.1 (DTR#); also elsewhere on the board
GND: C17.2, C18.2, C19.2, C20.2, D2.2 (G2), D2.5 (G5), D3.2 (G2), D3.5 (G5), D4.2 (G2), D4.5 (G5), D5.2 (G2), D5.5 (G5), D7.3 (A), D7.6 (A), D8.3 (A), D8.6 (A), D9.3 (A), D9.6 (A), DIGITAL1.7, DIGITAL1-TEST.4, ICSP.6, L.C, U4.6 (GND), U4.16 (GND), USB.GND, USB.GND@1 (GND), USB.GND@3 (GND); also elsewhere on the board
MISO: D3.3 (Z3), ICSP.1, R16.2; also elsewhere on the board
MOSI: D3.4 (Z4), ICSP.4, R16.8 (2); also elsewhere on the board
MOSI-PIN: D11-J.1, R16.7 (1)
unnamed: L.A, R7.2
unnamed: ANALOG.5, ANALOG-TEST.5, SDA-J.2
unnamed: DIGITAL0.3, JP2.3, R15.5 (1)
unnamed: DIGITAL1.5, DIGITAL1-TEST.6, R16.1
unnamed: DIGITAL0.5, JP2.5, R14.1
unnamed: DIGITAL0.7, JP2.7, R14.5 (1)
unnamed: DIGITAL0.6, JP2.6, R14.3 (1)
unnamed: DIGITAL0.4, JP2.4, R15.7 (1)
unnamed: DIGITAL0.8, JP2.8, R14.7 (1)
unnamed: DIGITAL1.6, DIGITAL1-TEST.5, R16.5 (1)
unnamed: R7.4 (2), TX.C
unnamed: C17.1, U4.3 (VCCIO), U4.13 (3V3OUT), U4.14 (RESET#)
unnamed: R7.8 (2), RX.C
unnamed: R4.2, U4.12 (USBDM)
unnamed: R5.2, U4.11 (USBDP)
unnamed: L1.2, U4.15 (VCC)
unnamed: ANALOG.6, ANALOG-TEST.6, SCL-J.2
unnamed: R17.1, SDA-J.1
unnamed: ANALOG.1, ANALOG-TEST.1, R12.1
unnamed: ANALOG.2, ANALOG-TEST.2, R12.3 (1)
unnamed: ANALOG.3, ANALOG-TEST.3, R12.5 (1)
unnamed: ANALOG.4, ANALOG-TEST.4, R12.7 (1)
unnamed: R17.3 (1), SCL-J.1
unnamed: DIGITAL1.1, DIGITAL1-TEST.10, R13.3 (1)
unnamed: D11-J.2, DIGITAL1.4, DIGITAL1-TEST.7
unnamed: DIGITAL1.2, DIGITAL1-TEST.9, R13.5 (1)
unnamed: DIGITAL0.1, JP2.1, R15.1
unnamed: DIGITAL0.2, JP2.2, R15.3 (1)
PWM-10: DIGITAL1.3, DIGITAL1-TEST.8, R13.7 (1)
PWM-11: D11-J.3, R16.3 (1)
RESET: ICSP.5; also elsewhere on the board
RXD0: U4.20 (TXD), UART0.1; also elsewhere on the board
RXD1: D5.3 (Z3), R15.2; also elsewhere on the board
RXLED: R7.7 (1), U4.17 (CBUS1)
SCK: D3.6 (Z6), ICSP.3, R7.1, R16.6 (2); also elsewhere on the board
SCL: DIGITAL1.10, DIGITAL1-TEST.1, SCL-J.3; also elsewhere on the board
SDA: DIGITAL1.9, DIGITAL1-TEST.2, SDA-J.3; also elsewhere on the board
TXD0: U4.4 (RXD), UART0.2; also elsewhere on the board
TXD1: D5.1 (Z1), R15.4 (2); also elsewhere on the board
TXLED: R7.3 (1), U4.10 (CBUS2)
USBVCC: C20.1, D15.A, F2.1, L1.1
USB_5V: F2.2, USB.VBUS, USB_TEST.3
USB_N: C19.1, R4.1, USB.D-, USB_TEST.1
USB_P: C18.1, R5.1, USB.D+, USB_TEST.2
VBAT: USB_TEST.4; also elsewhere on the board

Notes on the sheet:
Zigduino r3
CC BY-SA 3.0
(c) Logos Electromechanical 2013
www.logos-electro.com/zigduino
Design based on Arduino Duemilanove
Analog Inputs
USB Interface
Digital1 I/O & ICSP
Digital0 I/O & ICSP

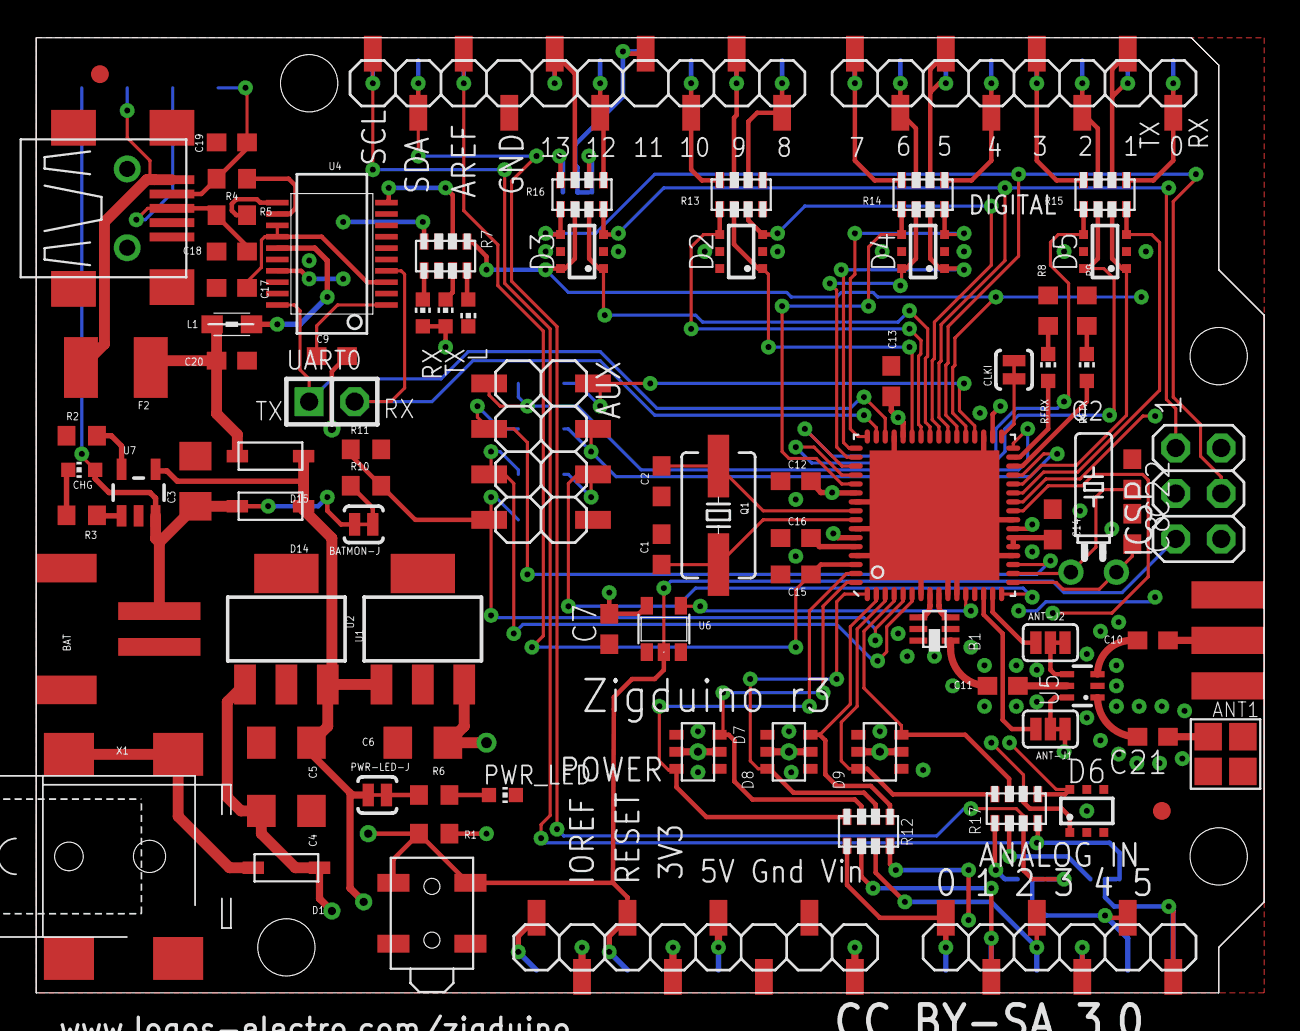
[picture p10: board zigduino-r3a.brd from above]

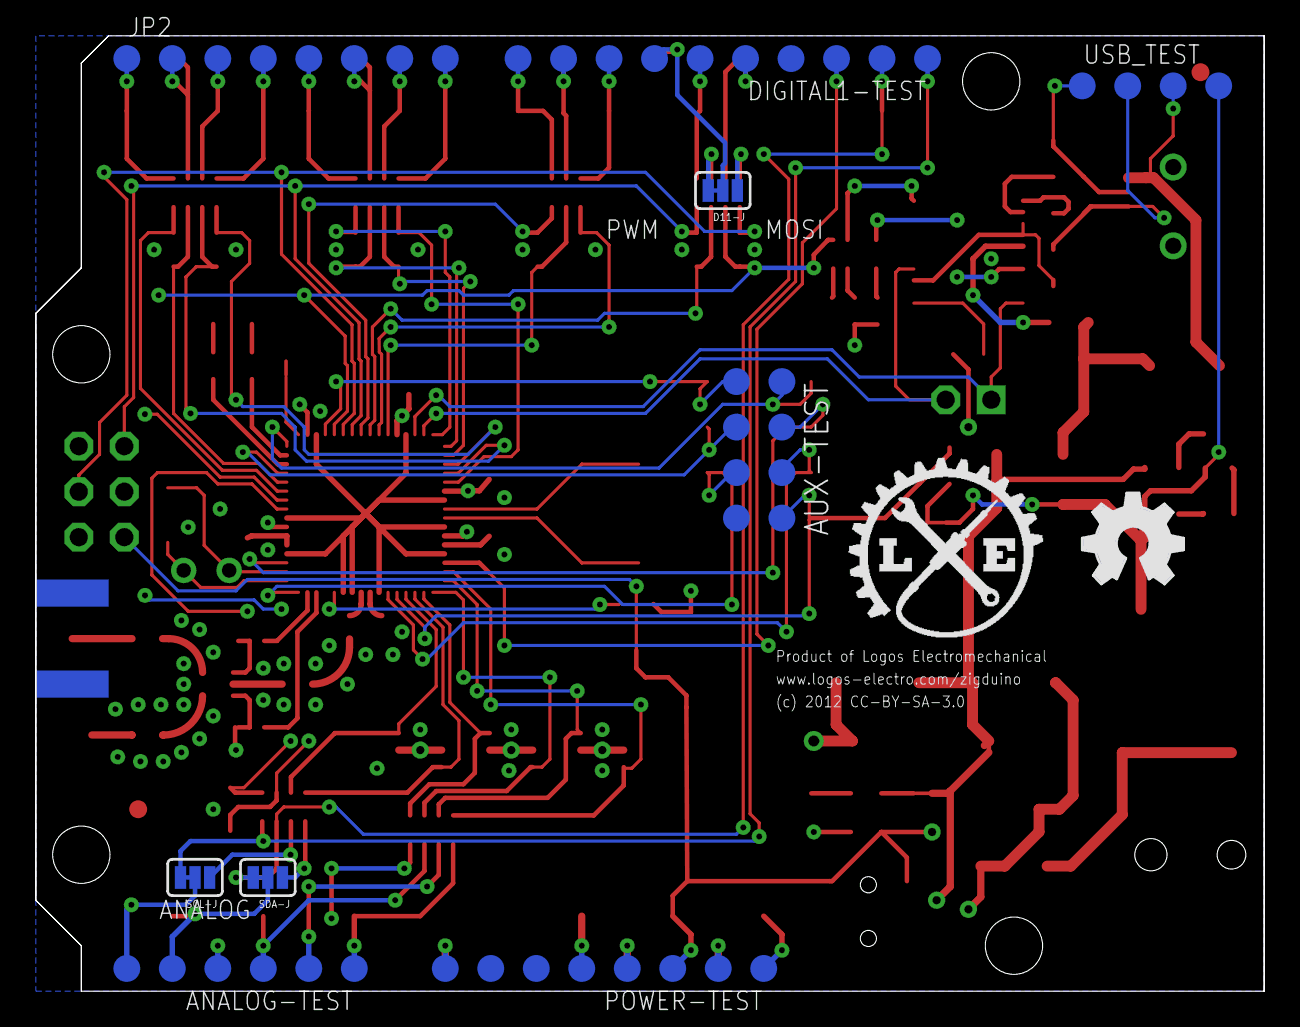
[picture p11: board zigduino-r3a.brd from below]

Board: 4 copper layers, 68.6 x 53.3 mm, 100 parts (11 on the bottom side), 111 nets.

Other parts of the board:
U$3, U$5: FIDUCIAL_G10
U$4: LOGO-SM
