logos-electromechanical/Zigduino-Hardware/Micro/zigduino-micro-2.brd

## EAGLE design Micro/zigduino-micro-2.brd (2013-12-27)

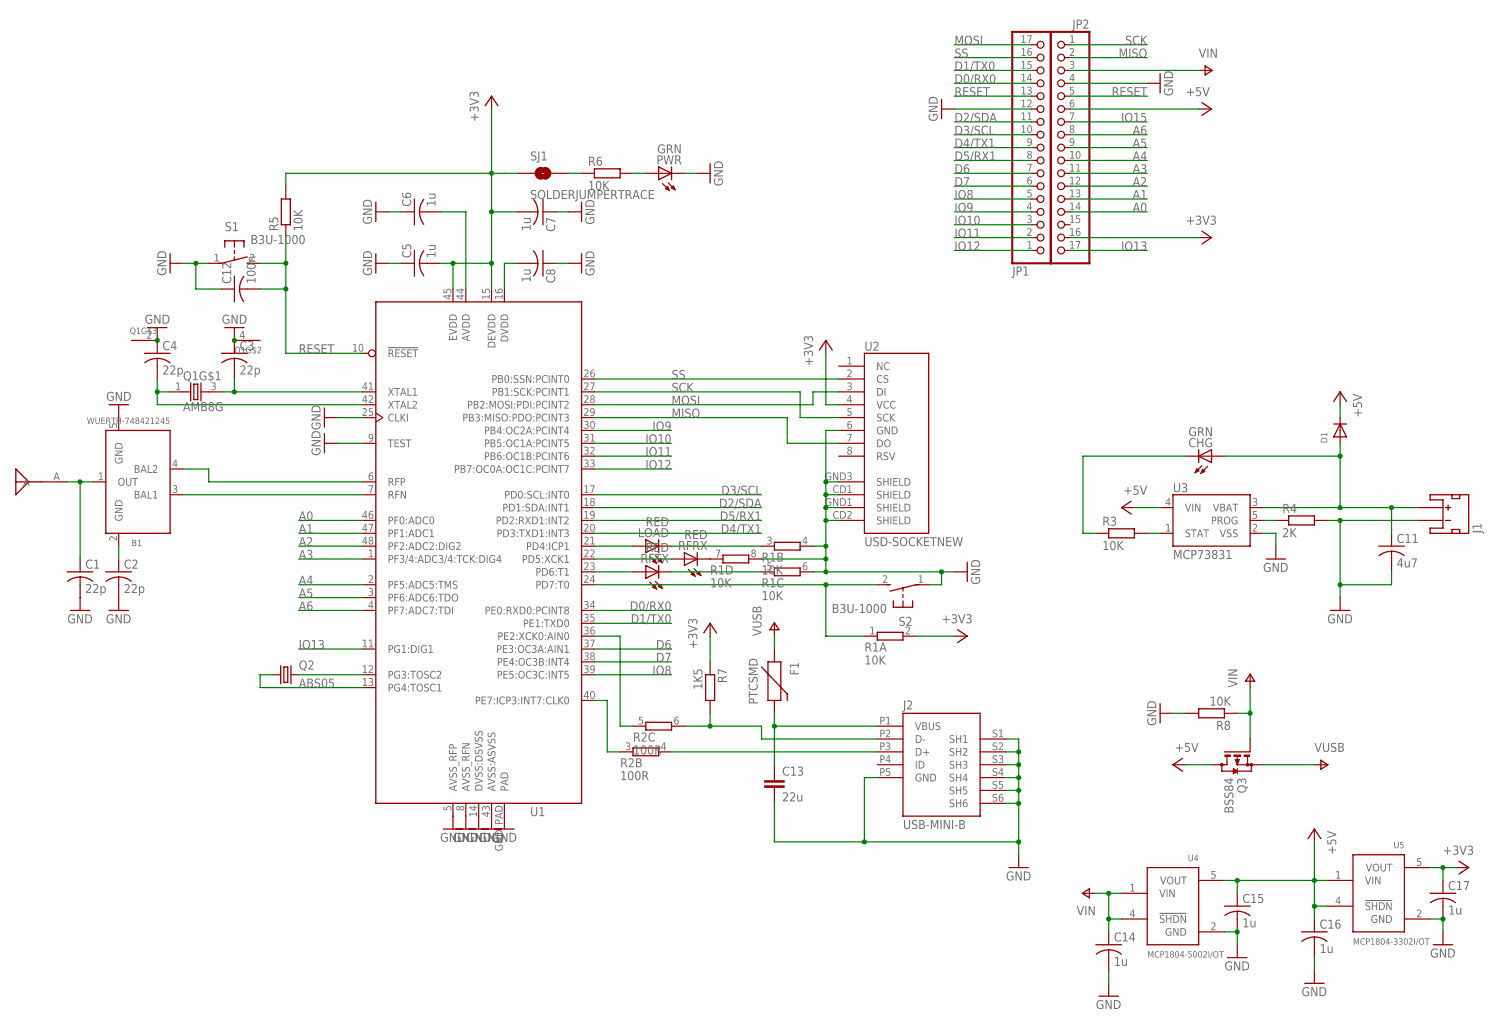
[picture p12: schematic zigduino-micro-2.sch]

Parts:
ANT1: ATMEGA128RFA1_MOLEX-ANT
B1: WUERTH-748421245; WURTH-BALUN
C1, C2, C3, C4: 22p; C0603
C5, C6, C7, C8, C14, C15, C16, C17: 1u; C0603
C11: 4u7; C0603
C12: 100n; C0603
C13: 22u; C0805
CHG: GRN; CHIPLED_0603
D1: DIODESOD-123; SOD-123
F1: PTCSMD; PTC-1206
J1: JST_2MM_MALE; JST-2-SMD
J2: USB-MINI-B; SMARTPRJ_CON2_USB_MICRO_B_AT
JP1, JP2: PINHD-1X17_2.54-SMD; 1X17SMD
LOAD: RED; CHIPLED_0603
PWR: GRN; CHIPLED_0603
Q1: AMB8G; ABM8G
Q2: ABS05
Q3: BSS84; SOT23
R1: 10K; CTS742C083-RES
R2: 100R; CTS742C083-RES
R3, R5, R6, R8: 10K; R0603
R4: 2K; R0603
R7: 1K5; R0603
RFRX: RED; CHIPLED_0603
RFTX: RED; CHIPLED_0603
S1, S2: B3U-1000; B3U
SJ1: SOLDERJUMPERTRACE; SJ_2S-TRACE
U1: ATMEGA1284RFR2; QFN48
U2: USD-SOCKETNEW; MICRO-SD-SOCKET-PP
U3: MCP73831; SOT23-5
U4: MCP1804-5002I/OT; SOT23-5L
U5: MCP1804-3302I/OT; SOT23-5L

Connections:
+3V3: C5.2, C7.2, C17.1, JP2.16, R1.2, R5.2, R7.1, SJ1.1, U1.15 (DEVDD), U1.45 (EVDD), U2.4 (VCC), U5.5 (VOUT)
+5V: C15.1, C16.1, D1.C, JP2.6, Q3.3 (D), U3.4 (VIN), U4.5 (VOUT), U5.1 (VIN), U5.4 (!SHDN!)
A0: JP2.14, U1.46 (PF0:ADC0)
A1: JP2.13, U1.47 (PF1:ADC1)
A2: JP2.12, U1.48 (PF2:ADC2:DIG2)
A3: JP2.11, U1.1 (PF3/4:ADC3/4:TCK:DIG4)
A4: JP2.10, U1.2 (PF5:ADC5:TMS)
A5: JP2.9, U1.3 (PF6:ADC6:TDO)
A6: JP2.8, U1.4 (PF7:ADC7:TDI)
D0/RX0: JP1.14, U1.34 (PE0:RXD0:PCINT8)
D1/TX0: JP1.15, U1.35 (PE1:TXD0)
D2/SDA: JP1.11, U1.18 (PD1:SDA:INT1)
D3/SCL: JP1.10, U1.17 (PD0:SCL:INT0)
D4/TX1: JP1.9, U1.20 (PD3:TXD1:INT3)
D5/RX1: JP1.8, U1.19 (PD2:RXD1:INT2)
D6: JP1.7, U1.37 (PE3:OC3A:AIN1)
D7: JP1.6, U1.38 (PE4:OC3B:INT4)
GND: B1.5 (GND), C1.2, C2.2, C3.1, C4.1, C5.1, C6.1, C7.1, C8.1, C11.2, C12.1, C13.2, C14.2, C15.2, C16.2, C17.2, J1.1 (-), J2.P5 (GND), J2.S1 (SH1), J2.S2 (SH2), J2.S3 (SH3), J2.S4 (SH4), J2.S5 (SH5), J2.S6 (SH6), JP1.12, JP2.4, PWR.C, Q1.2 (PIN), Q1.4 (PIN), R1.4 (2), R1.6 (2), R1.8 (2), R4.2, R8.2, S1.1, S2.1, U1.5 (AVSS_RFP), U1.8 (AVSS_RFN), U1.9 (TEST), U1.14 (DVSS:DSVSS), U1.25 (CLKI), U1.43 (AVSS:ASVSS), U1.GND_PAD (PAD), U2.6 (GND), U2.CD1 (SHIELD), U2.CD2 (SHIELD), U2.GND1 (SHIELD), U2.GND3 (SHIELD), U3.2 (VSS), U4.2 (GND), U5.2 (GND)
IO8: JP1.5, U1.39 (PE5:OC3C:INT5)
IO9: JP1.4, U1.30 (PB4:OC2A:PCINT4)
IO10: JP1.3, U1.31 (PB5:OC1A:PCINT5)
IO11: JP1.2, U1.32 (PB6:OC1B:PCINT6)
IO12: JP1.1, U1.33 (PB7:OC0A:OC1C:PCINT7)
IO13: JP2.17, U1.11 (PG1:DIG1)
IO15: JP2.7
MISO: JP2.2, U1.29 (PB3:MISO:PDO:PCINT3), U2.7 (DO)
MOSI: JP1.17, U1.28 (PB2:MOSI:PDI:PCINT2), U2.3 (DI)
unnamed: ANT1.A, B1.1 (OUT), C1.1
unnamed: B1.3 (BAL1), U1.7 (RFN)
unnamed: B1.4 (BAL2), U1.6 (RFP)
unnamed: B1.2 (GND), C2.1
unnamed: C3.2, Q1.3 (2), U1.41 (XTAL1)
unnamed: Q2.2, U1.12 (PG3:TOSC2)
unnamed: C4.2, Q1.1, U1.42 (XTAL2)
unnamed: C6.2, U1.44 (AVDD)
unnamed: Q2.1, U1.13 (PG4:TOSC1)
unnamed: C8.2, U1.16 (DVDD)
unnamed: LOAD.A, U1.21 (PD4:ICP1)
unnamed: R2.3 (1), U1.40 (PE7:ICP3:INT7:CLK0)
unnamed: R2.5 (1), U1.36 (PE2:XCK0:AIN0)
unnamed: RFTX.A, U1.23 (PD6:T1)
unnamed: PWR.A, R6.2
unnamed: RFRX.A, U1.22 (PD5:XCK1)
unnamed: R1.7 (1), RFRX.C
unnamed: R1.5 (1), RFTX.C
unnamed: J2.P2 (D-), R2.6 (2), R7.2
unnamed: J2.P3 (D+), R2.4 (2)
unnamed: LOAD.C, R1.3 (1)
unnamed: R1.1, S2.2, U1.24 (PD7:T0)
unnamed: R6.1, SJ1.2
unnamed: C11.1, CHG.A, D1.A, J1.2 (+), U3.3 (VBAT)
unnamed: R3.2, U3.1 (STAT)
unnamed: R4.1, U3.5 (PROG)
unnamed: C13.1, F1.2, J2.P1 (VBUS)
unnamed: CHG.C, R3.1
RESET: C12.2, JP1.13, JP2.5, R5.1, S1.2, U1.10 (!RESET!)
SCK: JP2.1, U1.27 (PB1:SCK:PCINT1), U2.5 (SCK)
SS: JP1.16, U1.26 (PB0:SSN:PCINT0), U2.2 (CS)
VIN: C14.1, JP2.3, Q3.1 (G), R8.1, U4.1 (VIN), U4.4 (!SHDN!)
VUSB: F1.1, Q3.2 (S)

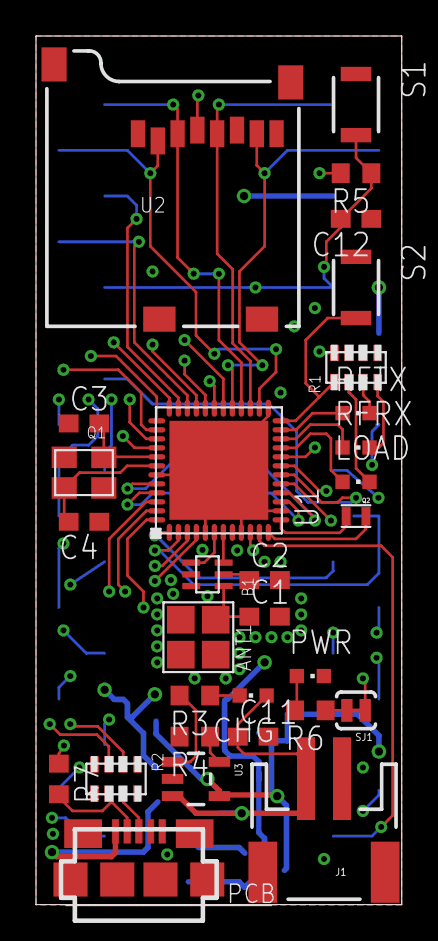
[picture p13: board zigduino-micro-2.brd from above]

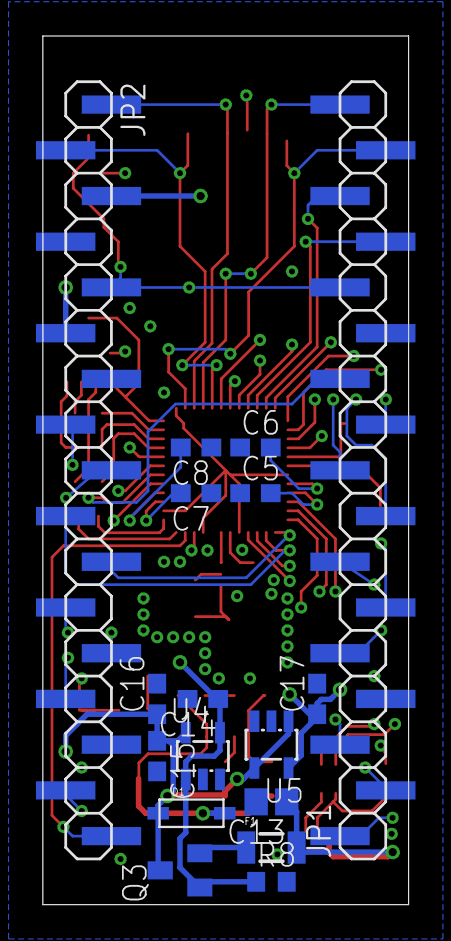
[picture p14: board zigduino-micro-2.brd from below]

Board: 4 copper layers, 20.3 x 48.3 mm, 47 parts (17 on the bottom side), 59 nets.
