logos-electromechanical/Zigduino-Hardware/Main/zigduino-v6d.brd

## EAGLE design Main/zigduino-v6d.brd (2013-06-16)

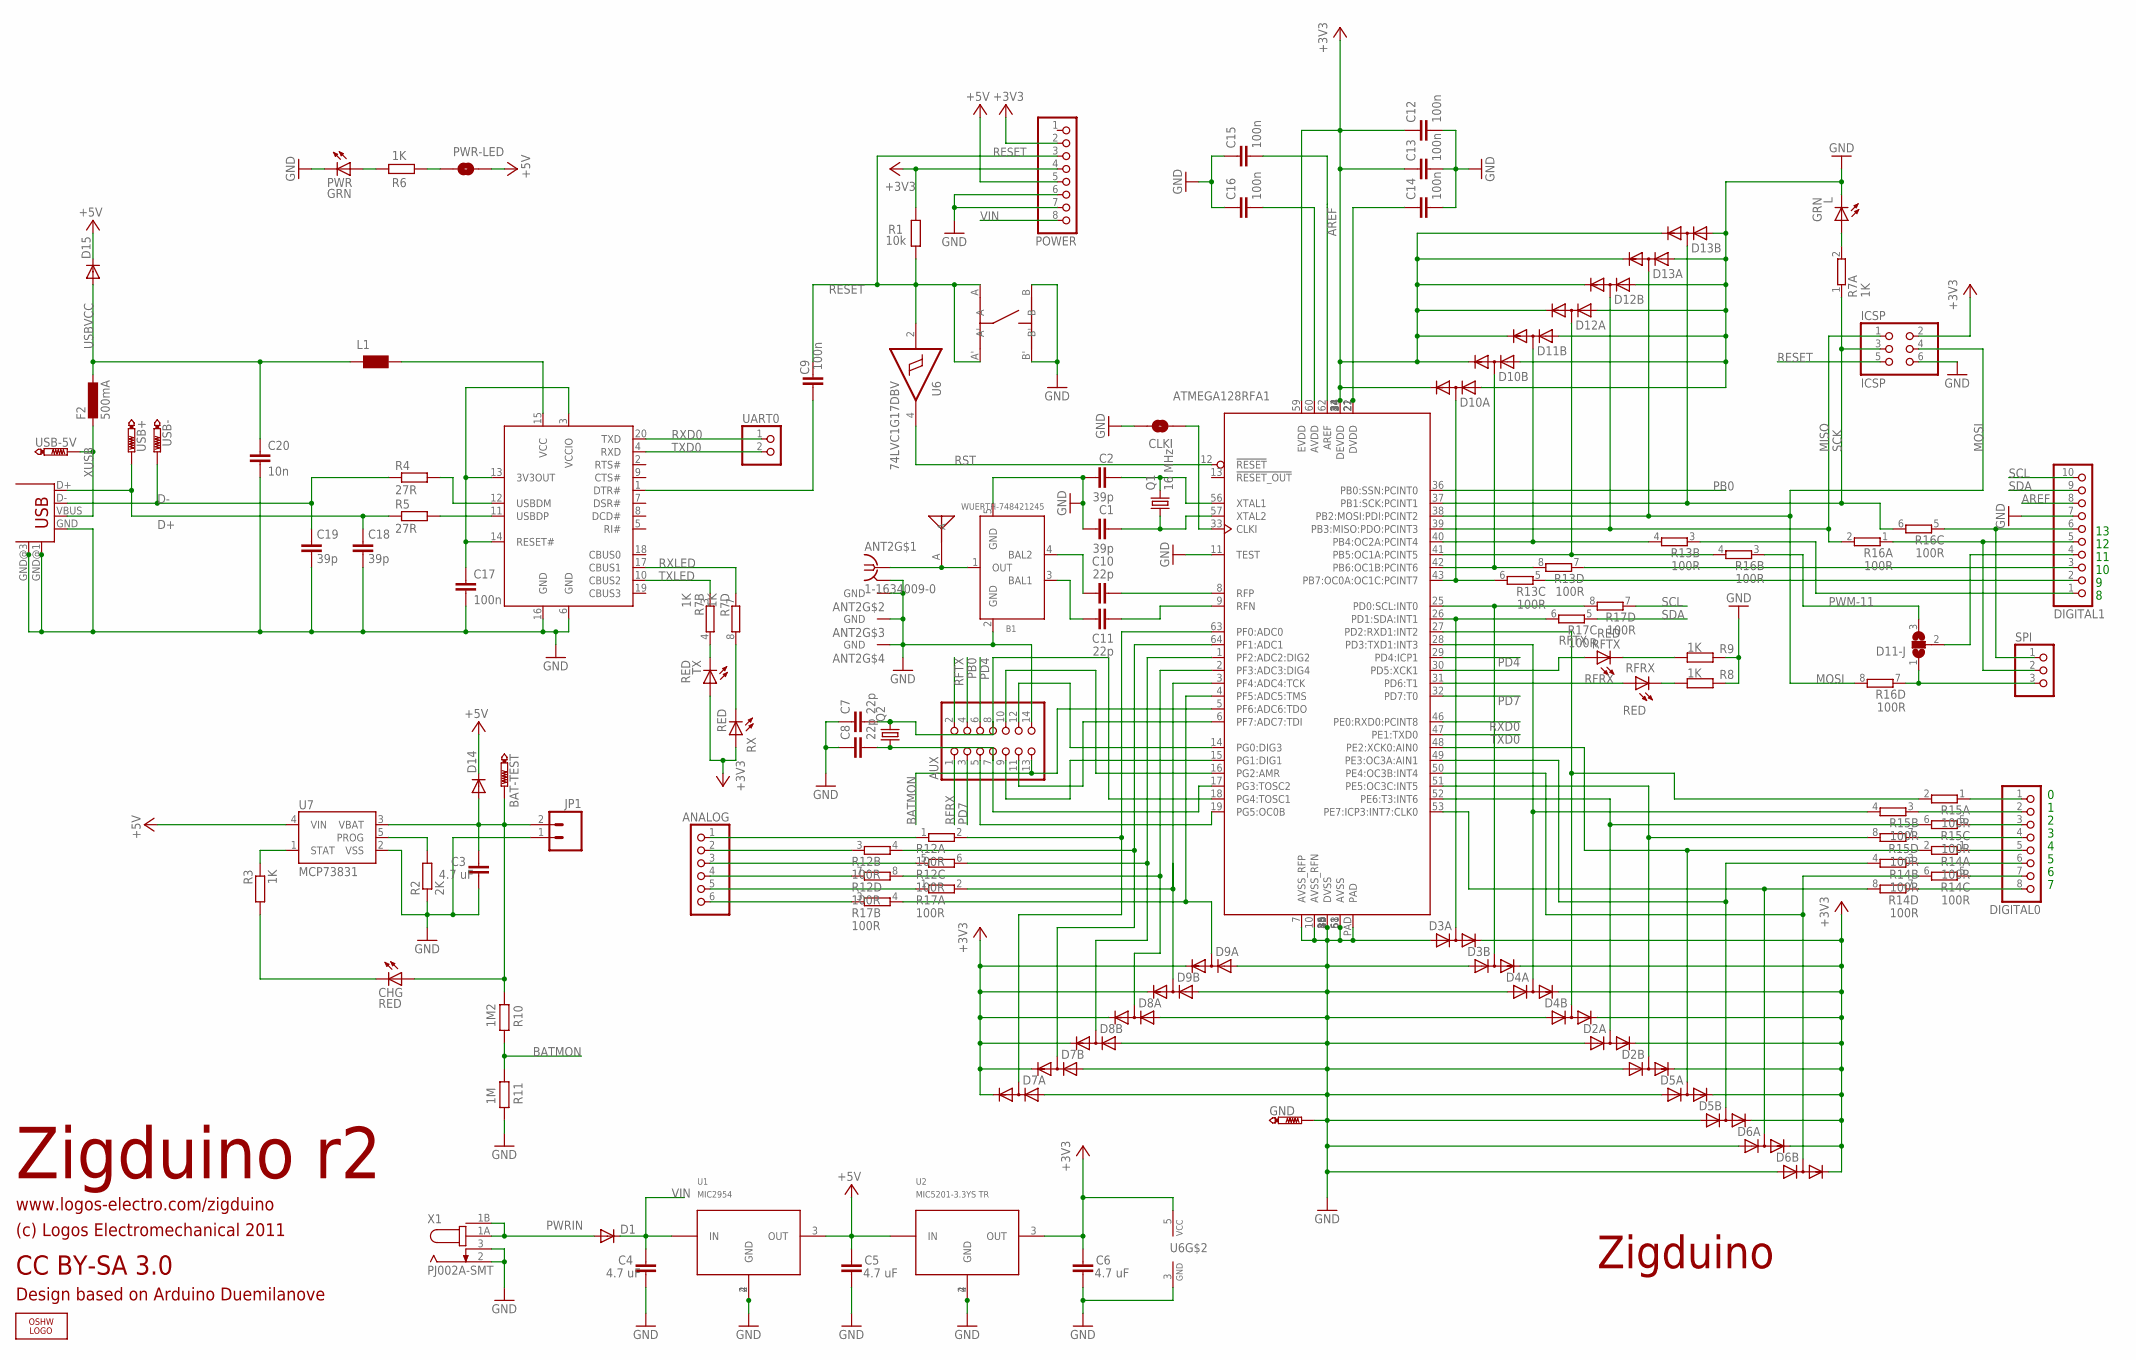
[picture p15: schematic zigduino-v6d.sch]

Parts:
ANALOG: PINHD-1X6; 1X06; PARTNO 19742
ANT1: MOLEX-ANT; PARTNO 0479480001
ANT2: 1-1634009-0; MMCX-THRU
AUX: PINHD-2X7_2.00; 2X07M; PARTNO 00217
B1: WUERTH-748421245; WURTH-BALUN; PARTNO 748421245
BAT-TEST: PTR1TP13SQ; TP13SQ; PARTNO TP13
C1, C2, C18, C19: 39p; C0603; PARTNO C1608C0G1H390J
C3, C4, C5, C6: 4.7 uF; C1206; PARTNO C3216Y5V1H475Z
C7, C8, C10, C11: 22p; C0603; PARTNO GQM1885C1H220JB01D
C9, C12, C13, C14, C15, C16, C17: 100n; C0603; PARTNO CC0603MRY5V9BB104
C20: 10n; C0603; PARTNO GRM188R71H103KA01D
CHG: RED; CHIP-LED0603; PARTNO LTST-C193KRKT-5A
CLKI: SOLDERJUMPERTRACE; SJ_2S-TRACE
D1, D14, D15: DIODE-SMB; SMB; PARTNO B150B-13-F
D2, D3, D4, D5, D6, D7, D8, D9, D10, D11, D12, D13: SD103ASDM; SOT26; PARTNO SD103ASDM-7
D11-J: SJ2W; SJ_2; PARTNO SJ3
DIGITAL0: PINHD-1X8; 1X08; PARTNO 19743
DIGITAL1: PINHD-1X10; 1X10; PARTNO 20083
F2: 500mA; L1812; PARTNO MF-MSMF050-2
GND: PTR1TP13SQ; TP13SQ; PARTNO TP13
ICSP: ICSP; 2X03; PARTNO 961206-6404-AR
JP1: M02-JST-2MM-SMT; S2B-PH; PARTNO S2B-PH-SM4-TB(LF)(SN)
L: GRN; CHIP-LED0603; PARTNO LTST-C193KGKT-5A
L1: WE-CBF_0805; 0805; PARTNO MI0805K400R-10
LOGO1: OSHW_LOGO_FILLX0200-NT; OSHW_FILLX200_NOTEXT
POWER: PINHD-1X8; 1X08; PARTNO 19743
PWR: GRN; CHIP-LED0603; PARTNO LTST-C193KGKT-5A
PWR-LED: SOLDERJUMPERTRACE; SJ_2S-TRACE
Q1: 16 MHz; CSM-3X; PARTNO ECS-160-20-3X-TR
Q2: CRYSTALTC26H; TC26H
R1: 10k; R0603; PARTNO RMCF0603FT10K0
R2: 2K; R0603; PARTNO RC0603FR-072KL
R3, R6, R8, R9: 1K; R0603; PARTNO RMCF0603FT1K00
R4, R5: 27R; R0603; PARTNO RC0603JR-0727RL
R7: 1K; CTS742C083-RES; PARTNO 742C083102JPTR
R10: 1M2; R0603; PARTNO ERJ-3EKF1204V
R11: 1M; R0603; PARTNO ERJ-3EKF1004V
R12, R13, R14, R15, R16, R17: 100R; CTS742C083-RES; PARTNO 742C083101JPTR
RFRX: RED; CHIP-LED0603; PARTNO LTST-C193KRKT-5A
RFTX: RED; CHIP-LED0603; PARTNO LTST-C193KRKT-5A
RX: RED; CHIP-LED0603; PARTNO LTST-C193KRKT-5A
SPI: PINHD-1X3; 1X03; PARTNO 20152
SW1: EVQ-PSD02K; EVQPSD02K; PARTNO EVQ-PSD02K
TX: RED; CHIP-LED0603; PARTNO LTST-C193KRKT-5A
U1: MIC2954; SOT223; PARTNO MIC2954-03WS-TR
U2: MIC5201-3.3YS TR; SOT223; PARTNO MIC5201-3.3YS TR
U3: ATMEGA128RFA1; QFN64; PARTNO ATMEGA128RFA1-ZUR
U4: FT231XS-R; SSOP20; PARTNO FT231XS-R
U6: 74LVC1G17DBV; SOT23-5; PARTNO SN74LVC1G17DBVR
U7: MCP73831; SOT23-5; PARTNO MCP73831T-2ACI/OT
UART0: PINHD-1X2; 1X02; PARTNO 00522
USB: USB-MB-S; PARTNO 20236
USB+: PTR1TP13SQ; TP13SQ; PARTNO TP13
USB-, USB-5V: PTR1TP13SQ; TP13SQ; PARTNO TP13
X1: PJ002A-SMT; PARTNO PJ-002AH-SMT

Connections:
+3V3: C6.1, C12.1, C13.1, D2.2 (C), D2.5 (C), D3.2 (C), D3.5 (C), D4.2 (C), D4.5 (C), D5.2 (C), D5.5 (C), D6.2 (C), D6.5 (C), D7.2 (C), D7.5 (C), D8.2 (C), D8.5 (C), D9.2 (C), D9.5 (C), D10.2 (C), D10.5 (C), D11.5 (C), D12.2 (C), D12.5 (C), D13.2 (C), D13.5 (C), ICSP.2, POWER.2, POWER.4, R1.2, RX.A, TX.A, U2.3 (OUT), U3.23 (DEVDD), U3.34 (DEVDD), U3.44 (DEVDD), U3.54 (DEVDD), U3.59 (EVDD), U6.5 (VCC)
+5V: C5.1, D14.C, D15.C, POWER.5, PWR-LED.2, U1.3 (OUT), U2.1 (IN), U7.4 (VIN)
AREF: C15.2, DIGITAL1.8, U3.62 (AREF)
BATMON: AUX.13, R10.2, R11.1, U3.5 (PF6:ADC6:TDO)
D+: C18.1, R5.1, USB.D+, USB+.TP
D-: C19.1, R4.1, USB.D-, USB-.TP
DTR: C9.1, U4.1 (DTR#)
GND: ANT2.G@0 (GND), ANT2.G@1 (GND), ANT2.G@2 (GND), ANT2.G@3 (GND), AUX.14, B1.2 (GND), B1.5 (GND), C1.1, C2.1, C3.2, C4.2, C5.2, C6.2, C7.1, C8.1, C12.2, C13.2, C14.2, C15.1, C16.1, C17.2, C18.2, C19.2, C20.2, CLKI.2, D2.3 (A), D2.6 (A), D3.3 (A), D3.6 (A), D4.3 (A), D4.6 (A), D5.3 (A), D5.6 (A), D6.3 (A), D6.6 (A), D7.3 (A), D7.6 (A), D8.3 (A), D8.6 (A), D9.3 (A), D9.6 (A), D10.3 (A), D10.6 (A), D11.6 (A), D12.3 (A), D12.6 (A), D13.3 (A), D13.6 (A), DIGITAL1.7, GND.TP, ICSP.6, JP1.1, L.C, POWER.6, POWER.7, PWR.C, R2.1, R8.1, R9.1, R11.2, SW1.B, SW1.B', U1.2 (GND), U1.4 (GND), U2.2 (GND), U2.4 (GND), U3.7 (AVSS_RFP), U3.10 (AVSS_RFN), U3.11 (TEST), U3.20 (DVSS), U3.24 (DVSS), U3.35 (DVSS), U3.45 (DVSS), U3.55 (DVSS), U3.58 (AVSS), U3.61 (AVSS), U3.PAD, U4.6 (GND), U4.16 (GND), U6.3 (GND), U7.2 (VSS), USB.GND, USB.GND@1 (GND), USB.GND@3 (GND), X1.2, X1.3
MISO: D12.1 (AC), ICSP.1, R16.2, U3.39 (PB3:MISO:PDO:PCINT3)
MOSI: D13.4 (AC), ICSP.4, R16.8 (2), U3.38 (PB2:MOSI:PDI:PCINT2)
MOSI-PIN: D11-J.1, R16.7 (1), SPI.3
unnamed: R9.2, RFTX.C
unnamed: L.A, R7.2
unnamed: PWR.A, R6.2
unnamed: B1.4 (BAL2), C10.1
unnamed: DIGITAL0.3, R15.5 (1)
unnamed: C1.2, Q1.1, U3.57 (XTAL2)
unnamed: C2.2, Q1.2, U3.56 (XTAL1)
unnamed: PWR-LED.1, R6.1
unnamed: B1.3 (BAL1), C11.1
unnamed: DIGITAL1.5, R16.1, SPI.2
unnamed: DIGITAL0.5, R14.1
unnamed: DIGITAL0.7, R14.5 (1)
unnamed: DIGITAL0.6, R14.3 (1)
unnamed: DIGITAL0.4, R15.7 (1)
unnamed: DIGITAL0.8, R14.7 (1)
unnamed: D3.1 (AC), R17.8 (2), U3.25 (PD0:SCL:INT0)
unnamed: D3.4 (AC), R17.6 (2), U3.26 (PD1:SDA:INT1)
unnamed: ANT1.A, ANT2.C (1), B1.1 (OUT)
unnamed: D12.4 (AC), R16.4 (2), U3.41 (PB5:OC1A:PCINT5)
unnamed: R8.2, RFRX.C
unnamed: D2.4 (AC), R15.6 (2), U3.52 (PE6:T3:INT6)
unnamed: D2.1 (AC), R15.8 (2), U3.51 (PE5:OC3C:INT5)
unnamed: C10.2, U3.8 (RFP)
unnamed: C11.2, U3.9 (RFN)
unnamed: DIGITAL1.6, R16.5 (1), SPI.1
unnamed: R2.2, U7.5 (PROG)
unnamed: R3.1, U7.1 (STAT)
unnamed: R7.4 (2), TX.C
unnamed: CHG.C, R3.2
unnamed: C17.1, U4.3 (VCCIO), U4.13 (3V3OUT), U4.14 (RESET#)
unnamed: R7.8 (2), RX.C
unnamed: D11.1 (AC), R13.4 (2), U3.40 (PB4:OC2A:PCINT4)
unnamed: CLKI.1, U3.33 (CLKI)
unnamed: R4.2, U4.12 (USBDM)
unnamed: R5.2, U4.11 (USBDP)
unnamed: L1.2, U4.15 (VCC)
unnamed: D10.1 (AC), R13.8 (2), U3.42 (PB6:OC1B:PCINT6)
unnamed: D10.4 (AC), R13.6 (2), U3.43 (PB7:OC0A:OC1C:PCINT7)
unnamed: D5.4 (AC), R14.2, U3.48 (PE2:XCK0:AIN0)
unnamed: D6.1 (AC), R14.6 (2), U3.50 (PE4:OC3B:INT4)
unnamed: D5.1 (AC), R14.4 (2), U3.49 (PE3:OC3A:AIN1)
unnamed: D6.4 (AC), R14.8 (2), U3.53 (PE7:ICP3:INT7:CLK0)
unnamed: ANALOG.5, R17.1
unnamed: ANALOG.6, R17.3 (1)
unnamed: AUX.11, U3.6 (PF7:ADC7:TDI)
unnamed: D7.4 (AC), R12.2, U3.63 (PF0:ADC0)
unnamed: D7.1 (AC), R12.4 (2), U3.64 (PF1:ADC1)
unnamed: D8.1 (AC), R12.6 (2), U3.1 (PF2:ADC2:DIG2)
unnamed: D8.4 (AC), R12.8 (2), U3.2 (PF3:ADC3:DIG4)
unnamed: D9.1 (AC), R17.2, U3.3 (PF4:ADC4:TCK)
unnamed: D9.4 (AC), R17.4 (2), U3.4 (PF5:ADC5:TMS)
unnamed: ANALOG.1, R12.1
unnamed: ANALOG.2, R12.3 (1)
unnamed: ANALOG.3, R12.5 (1)
unnamed: ANALOG.4, R12.7 (1)
unnamed: DIGITAL1.1, R13.3 (1)
unnamed: D11-J.2, DIGITAL1.4
unnamed: AUX.12, U3.14 (PG0:DIG3)
unnamed: C14.1, U3.21 (DVDD), U3.22 (DVDD)
unnamed: C16.2, U3.60 (AVDD)
unnamed: DIGITAL1.2, R13.5 (1)
unnamed: DIGITAL0.1, R15.1
unnamed: DIGITAL0.2, R15.3 (1)
unnamed: AUX.9, U3.15 (PG1:DIG1)
unnamed: AUX.5, U3.19 (PG5:OC0B)
unnamed: AUX.8, C7.2, Q2.2, U3.18 (PG4:TOSC1)
unnamed: AUX.7, C8.2, Q2.1, U3.17 (PG3:TOSC2)
unnamed: AUX.10, U3.16 (PG2:AMR)
PB0: AUX.4, U3.36 (PB0:SSN:PCINT0)
PD4: AUX.6, U3.29 (PD4:ICP1)
PD7: AUX.3, U3.32 (PD7:T0)
PWM-10: DIGITAL1.3, R13.7 (1)
PWM-11: D11-J.3, R16.3 (1)
PWRIN: D1.A, X1.1A, X1.1B
RESET: C9.2, ICSP.5, POWER.3, R1.1, SW1.A, SW1.A', U6.2 (I)
RFRX: AUX.1, RFRX.A, U3.31 (PD6:T1)
RFTX: AUX.2, RFTX.A, U3.30 (PD5:XCK1)
RST: U3.12 (!RESET!), U6.4 (O)
RXD0: U3.46 (PE0:RXD0:PCINT8), U4.20 (TXD), UART0.1
RXD1: D4.1 (AC), R15.2, U3.27 (PD2:RXD1:INT2)
RXLED: R7.7 (1), U4.17 (CBUS1)
SCK: D13.1 (AC), ICSP.3, R7.1, R16.6 (2), U3.37 (PB1:SCK:PCINT1)
SCL: DIGITAL1.10, R17.7 (1)
SDA: DIGITAL1.9, R17.5 (1)
TXD0: U3.47 (PE1:TXD0), U4.4 (RXD), UART0.2
TXD1: D4.4 (AC), R15.4 (2), U3.28 (PD3:TXD1:INT3)
TXLED: R7.3 (1), U4.10 (CBUS2)
USBVCC: C20.1, D15.A, F2.1, L1.1
VBAT: BAT-TEST.TP, C3.1, CHG.A, D14.A, JP1.2, R10.1, U7.3 (VBAT)
VIN: C4.1, D1.C, POWER.8, U1.1 (IN)
XUSB: F2.2, USB.VBUS, USB-5V.TP

Notes on the sheet:
Zigduino r2
CC BY-SA 3.0
(c) Logos Electromechanical 2011
www.logos-electro.com/zigduino
ATMEGA128RFA1
Zigduino
Design based on Arduino Duemilanove

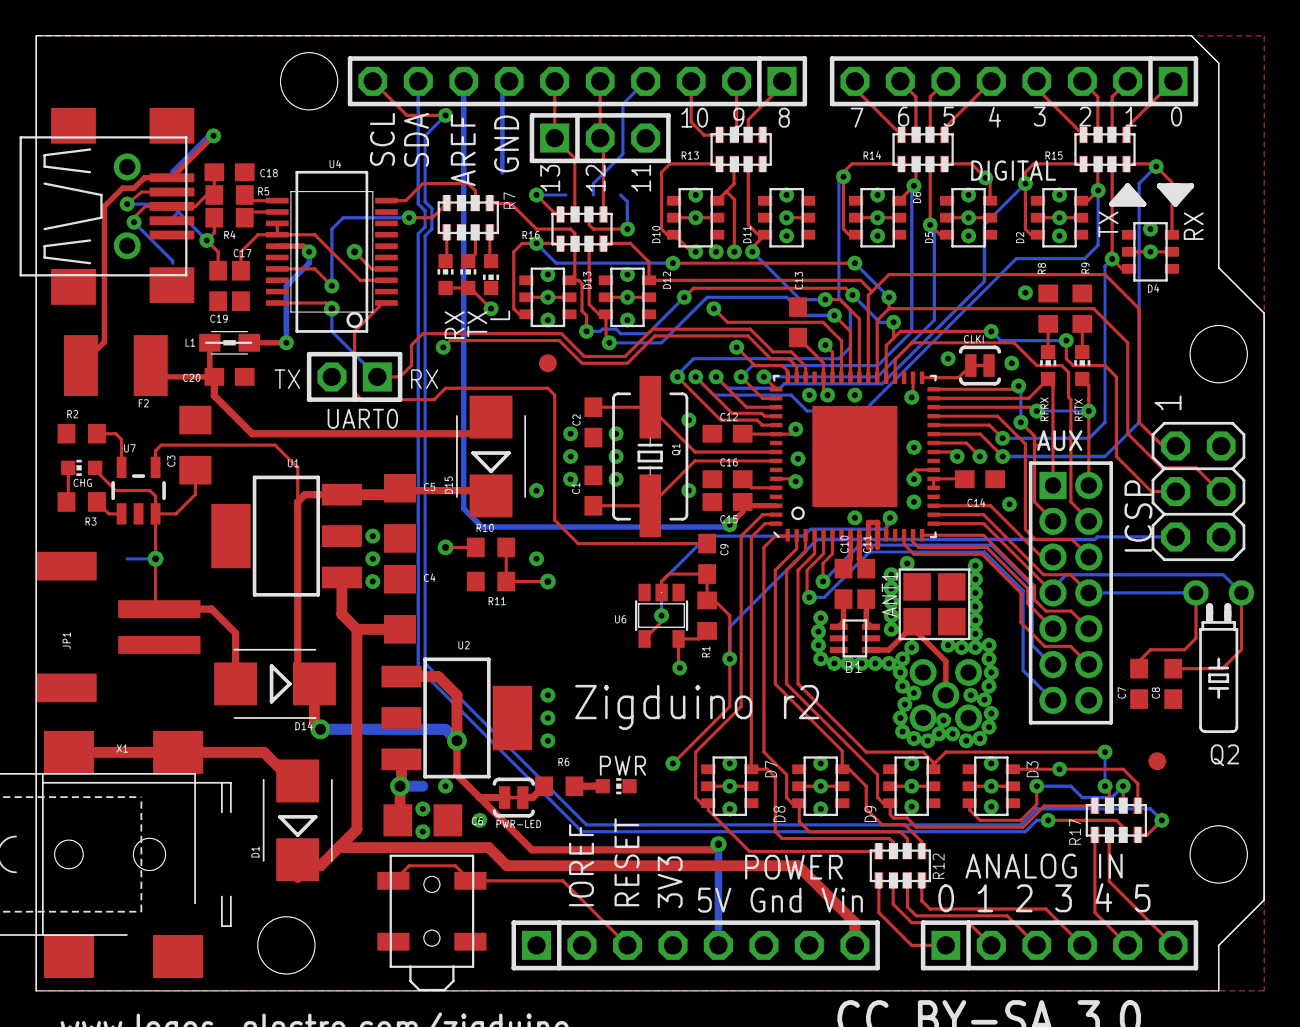
[picture p16: board zigduino-v6d.brd from above]

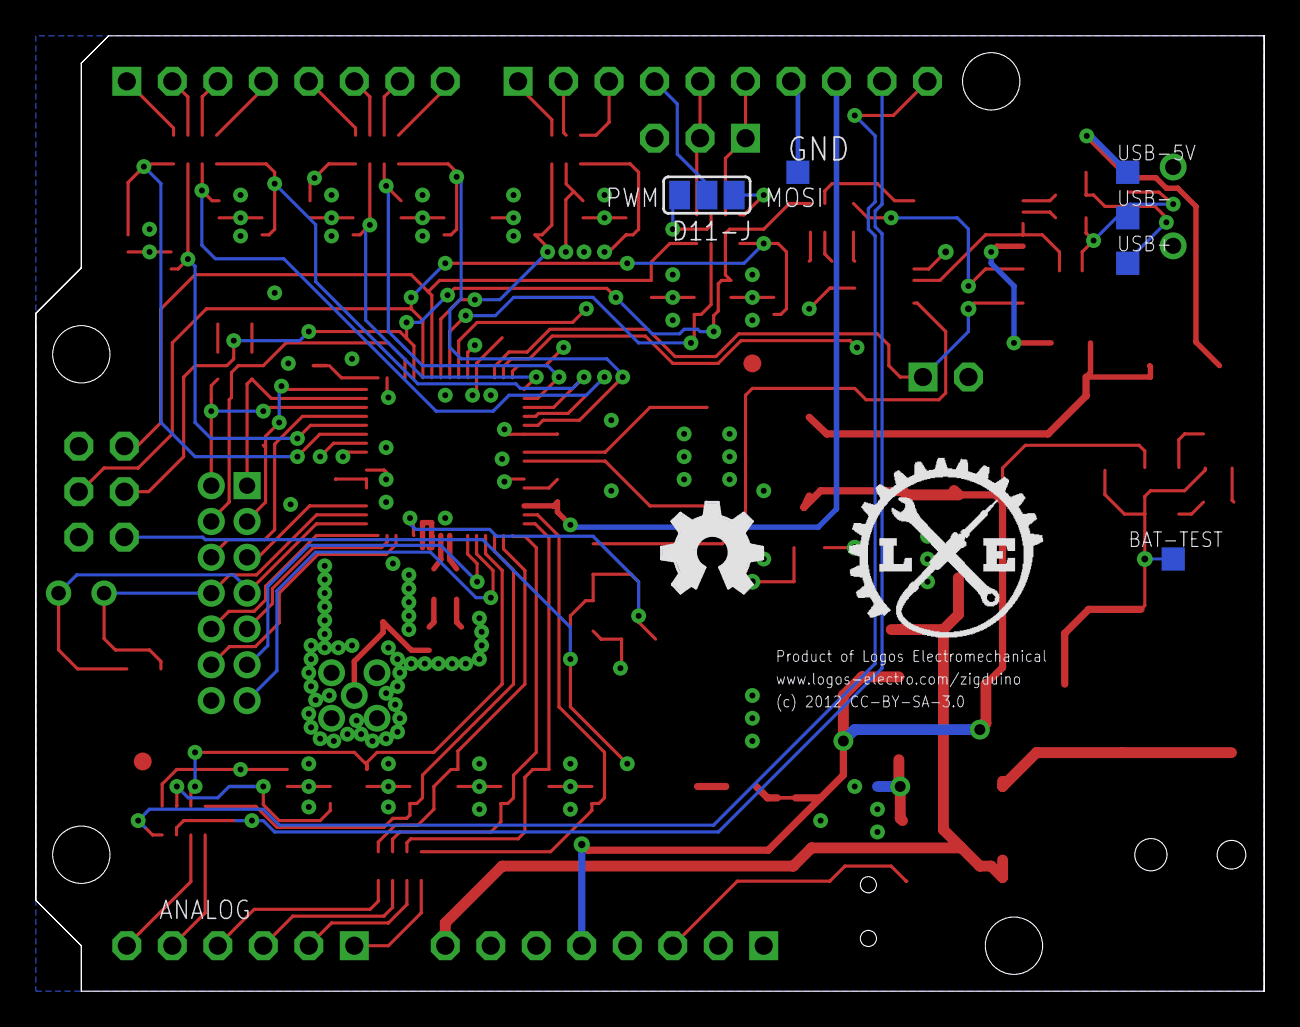
[picture p17: board zigduino-v6d.brd from below]

Board: 4 copper layers, 68.6 x 53.3 mm, 96 parts (8 on the bottom side), 102 nets.

Other parts of the board:
U$3, U$5: FIDUCIAL_G10
U$4: LOGO-SM
