logos-electromechanical/Zigduino-Hardware/Main/test/zigduino-v6c-test.brd

## EAGLE design Main/test/zigduino-v6c-test.brd (2013-02-24)

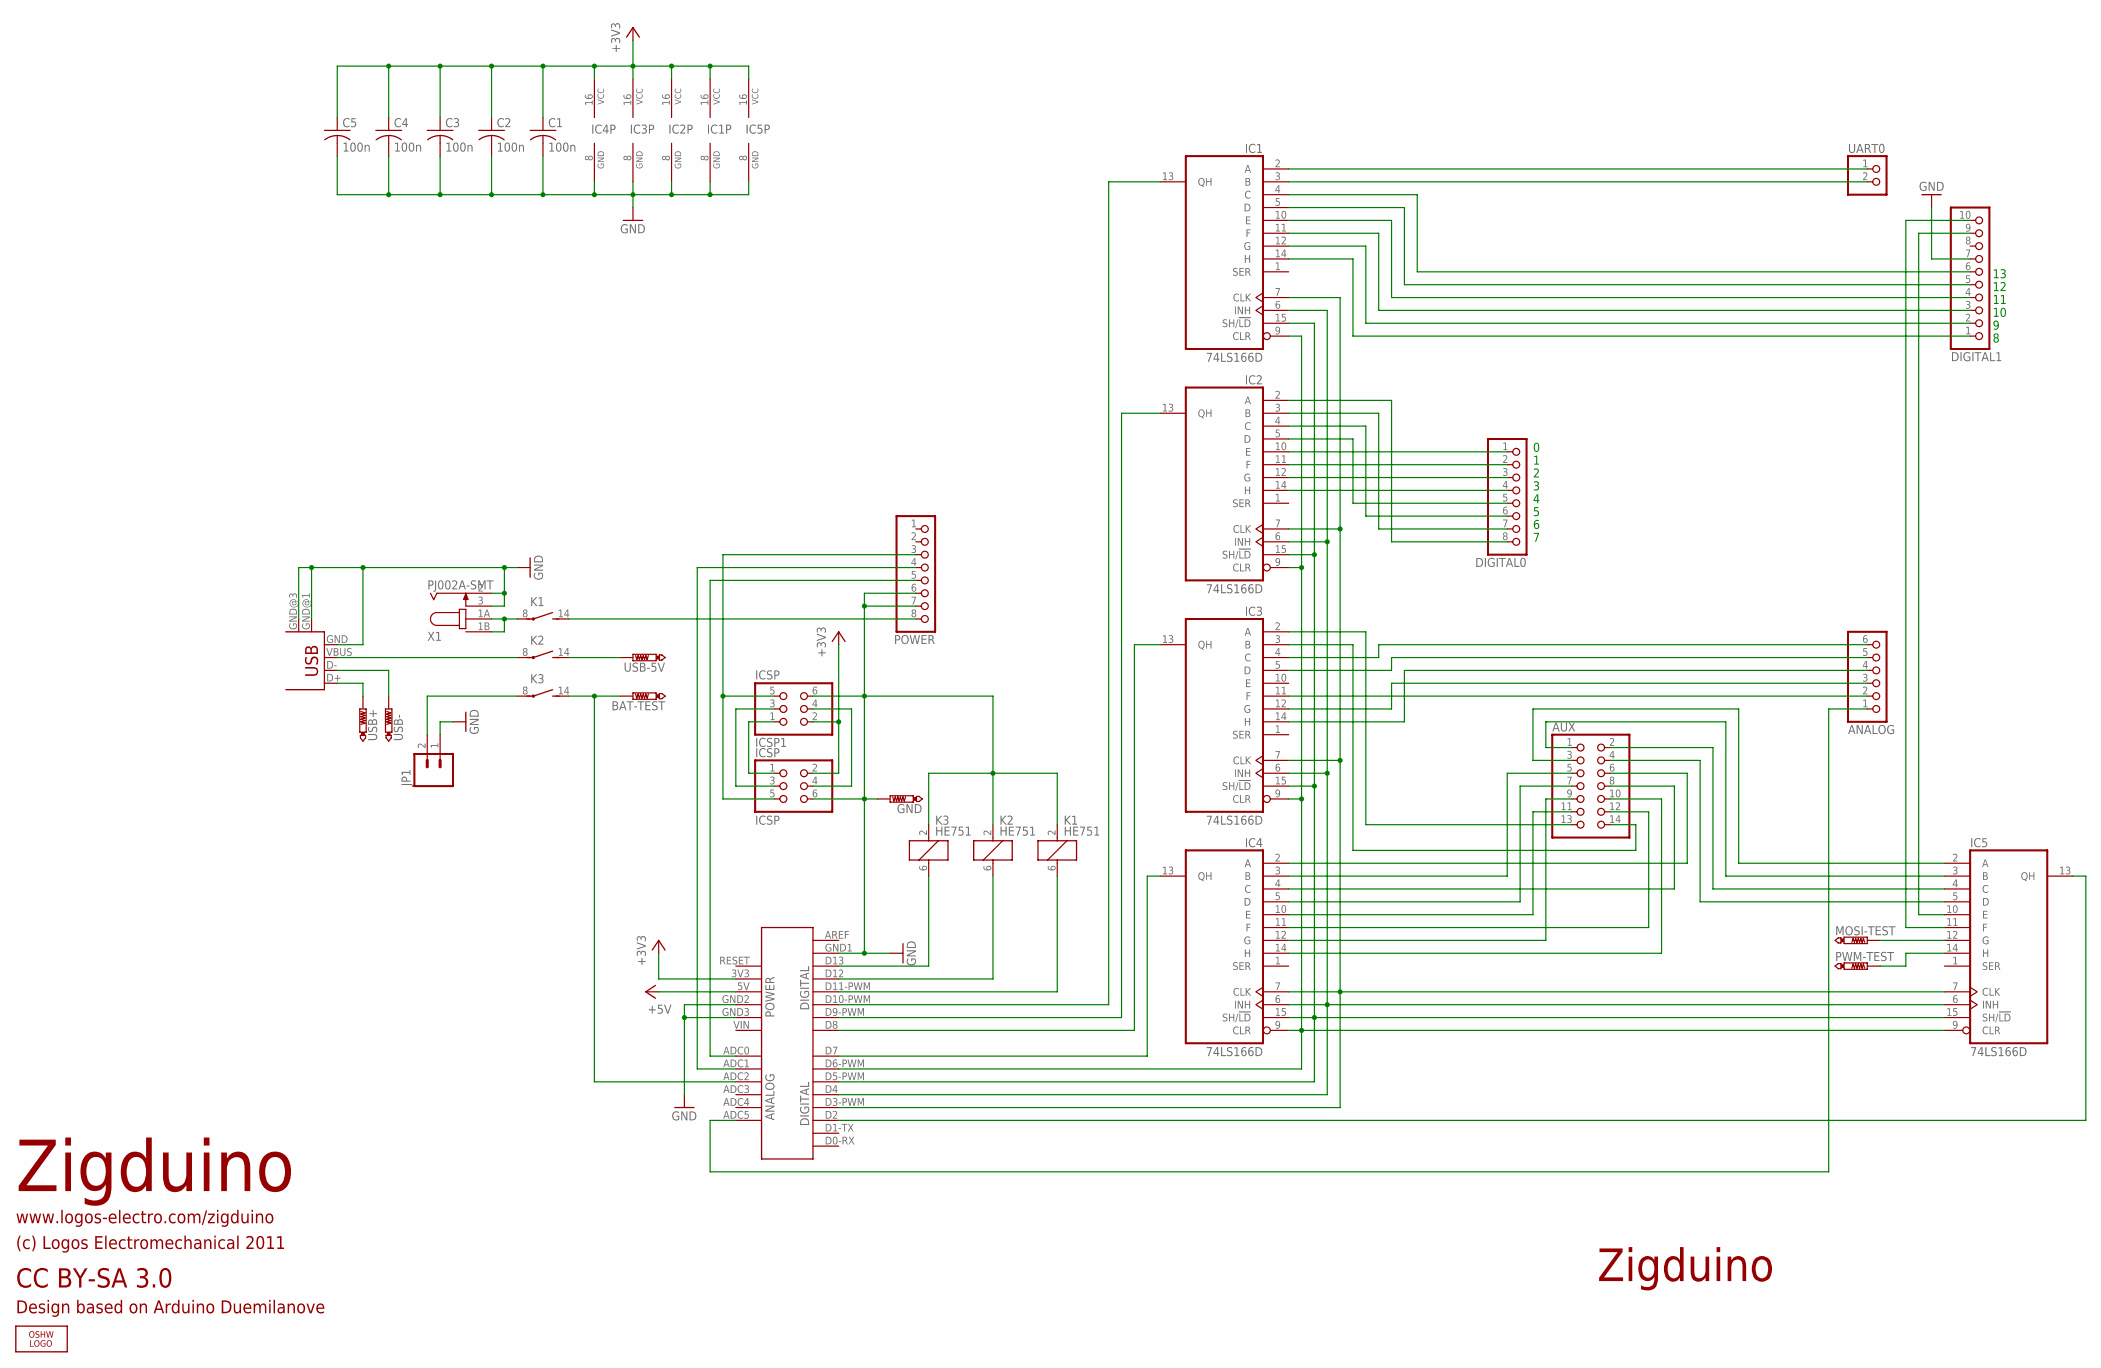
[picture p18: schematic zigduino-v6c-test.sch]

Parts:
ANALOG: PINHD-1X6; 1X06; PARTNO 19742
AUX: PINHD-2X7_2.00; 2X07M; PARTNO 00217
BAT-TEST: PTR1PAD1-13; P1-13; PARTNO TP13
C1, C2, C3, C4, C5: 100n; C0603
DIGITAL0: PINHD-1X8; 1X08; PARTNO 19743
DIGITAL1: PINHD-1X10; 1X10; PARTNO 20083
GND: PTR1PAD1-13; P1-13; PARTNO TP13
IC1, IC2, IC3, IC4, IC5: 74LS166D; SO16
ICSP, ICSP1: ICSP; 2X03; PARTNO 961206-6404-AR
JP1: M02-JST-2MM-SMT; S2B-PH
K1, K2, K3: HE751
LOGO1: OSHW_LOGO_FILLX0200-NT; OSHW_FILLX200_NOTEXT
MOSI-TEST: PTR1PAD1-13; P1-13; PARTNO TP13
POWER: PINHD-1X8; 1X08; PARTNO 19743
PWM-TEST: PTR1PAD1-13; P1-13; PARTNO TP13
SHIELD1: 2009
UART0: PINHD-1X2; 1X02; PARTNO 00522
USB1: USB-MB-S
USB+: PTR1PAD1-13; P1-13; PARTNO TP13
USB-, USB-5V: PTR1PAD1-13; P1-13; PARTNO TP13
X1: PJ002A-SMT

Connections:
+3V3: C1.1, C2.1, C3.1, C4.1, C5.1, IC1.16 (VCC), IC2.16 (VCC), IC3.16 (VCC), IC4.16 (VCC), IC5.16 (VCC), ICSP.2, ICSP1.2, SHIELD1.3V3
+5V: SHIELD1.5V
GND: C1.2, C2.2, C3.2, C4.2, C5.2, DIGITAL1.7, GND.TP, IC1.8 (GND), IC2.8 (GND), IC3.8 (GND), IC4.8 (GND), IC5.8 (GND), ICSP.6, ICSP1.6, JP1.1, K1.2 (1), K2.2 (1), K3.2 (1), POWER.6, POWER.7, SHIELD1.GND1, SHIELD1.GND2, SHIELD1.GND3, USB1.GND, USB1.GND@1 (GND), USB1.GND@3 (GND), X1.2, X1.3
unnamed: IC1.2 (A), UART0.1
unnamed: IC1.3 (B), UART0.2
unnamed: JP1.2, K3.8
unnamed: DIGITAL1.6, IC1.4 (C)
unnamed: DIGITAL1.5, IC1.5 (D)
unnamed: DIGITAL1.4, IC1.10 (E)
unnamed: DIGITAL1.3, IC1.11 (F)
unnamed: DIGITAL1.2, IC1.12 (G)
unnamed: DIGITAL1.1, IC1.14 (H)
unnamed: DIGITAL0.4, IC2.14 (H)
unnamed: DIGITAL0.3, IC2.12 (G)
unnamed: DIGITAL0.2, IC2.11 (F)
unnamed: DIGITAL0.1, IC2.10 (E)
unnamed: DIGITAL0.5, IC2.5 (D)
unnamed: DIGITAL0.6, IC2.4 (C)
unnamed: DIGITAL0.7, IC2.3 (B)
unnamed: DIGITAL0.8, IC2.2 (A)
unnamed: ANALOG.1, SHIELD1.ADC5
unnamed: ANALOG.6, IC3.4 (C)
unnamed: ANALOG.5, IC3.5 (D)
unnamed: ANALOG.4, IC3.14 (H)
unnamed: ANALOG.3, IC3.12 (G)
unnamed: ANALOG.2, IC3.11 (F)
unnamed: AUX.13, IC3.2 (A)
unnamed: AUX.14, IC3.3 (B)
unnamed: AUX.6, IC4.2 (A)
unnamed: AUX.5, IC4.3 (B)
unnamed: AUX.8, IC4.4 (C)
unnamed: AUX.7, IC4.5 (D)
unnamed: AUX.11, IC4.10 (E)
unnamed: AUX.12, IC4.11 (F)
unnamed: AUX.9, IC4.12 (G)
unnamed: AUX.3, IC5.2 (A)
unnamed: AUX.10, IC4.14 (H)
unnamed: AUX.2, IC5.4 (C)
unnamed: AUX.4, IC5.5 (D)
unnamed: AUX.1, IC5.3 (B)
unnamed: IC1.9 (CLR), IC2.9 (CLR), IC3.9 (CLR), IC4.9 (CLR), IC5.9 (CLR), SHIELD1.D6-PWM (D6)
unnamed: IC1.15 (SH/!LD), IC2.15 (SH/!LD), IC3.15 (SH/!LD), IC4.15 (SH/!LD), IC5.15 (SH/!LD), SHIELD1.D5-PWM (D5)
unnamed: IC1.6 (INH), IC2.6 (INH), IC3.6 (INH), IC4.6 (INH), IC5.6 (INH), SHIELD1.D4
unnamed: IC1.7 (CLK), IC2.7 (CLK), IC3.7 (CLK), IC4.7 (CLK), IC5.7 (CLK), SHIELD1.D3-PWM (D3)
unnamed: DIGITAL1.9, IC5.10 (E)
unnamed: DIGITAL1.10, IC5.11 (F)
unnamed: IC5.12 (G), MOSI-TEST.TP
unnamed: IC5.14 (H), PWM-TEST.TP
unnamed: IC1.13 (QH), SHIELD1.D10-PWM (D10)
unnamed: IC2.13 (QH), SHIELD1.D9-PWM (D9)
unnamed: IC3.13 (QH), SHIELD1.D8
unnamed: IC4.13 (QH), SHIELD1.D7
unnamed: IC5.13 (QH), SHIELD1.D2
unnamed: POWER.5, SHIELD1.ADC0
unnamed: POWER.4, SHIELD1.ADC1
unnamed: K1.14 (S), POWER.8
unnamed: K2.14 (S), USB-5V.TP
unnamed: BAT-TEST.TP, K3.14 (S), SHIELD1.ADC2
unnamed: K2.6 (2), SHIELD1.D12
unnamed: K1.6 (2), SHIELD1.D11-PWM (D11)
unnamed: ICSP.4, ICSP1.4
unnamed: K3.6 (2), SHIELD1.D13
unnamed: ICSP.1, ICSP1.1
unnamed: ICSP.3, ICSP1.3
unnamed: ICSP.5, ICSP1.5, POWER.3
unnamed: K2.8, USB1.VBUS
unnamed: USB1.D+, USB+.TP
unnamed: USB1.D-, USB-.TP
unnamed: K1.8, X1.1A, X1.1B

Notes on the sheet:
Zigduino
CC BY-SA 3.0
(c) Logos Electromechanical 2011
www.logos-electro.com/zigduino
Design based on Arduino Duemilanove

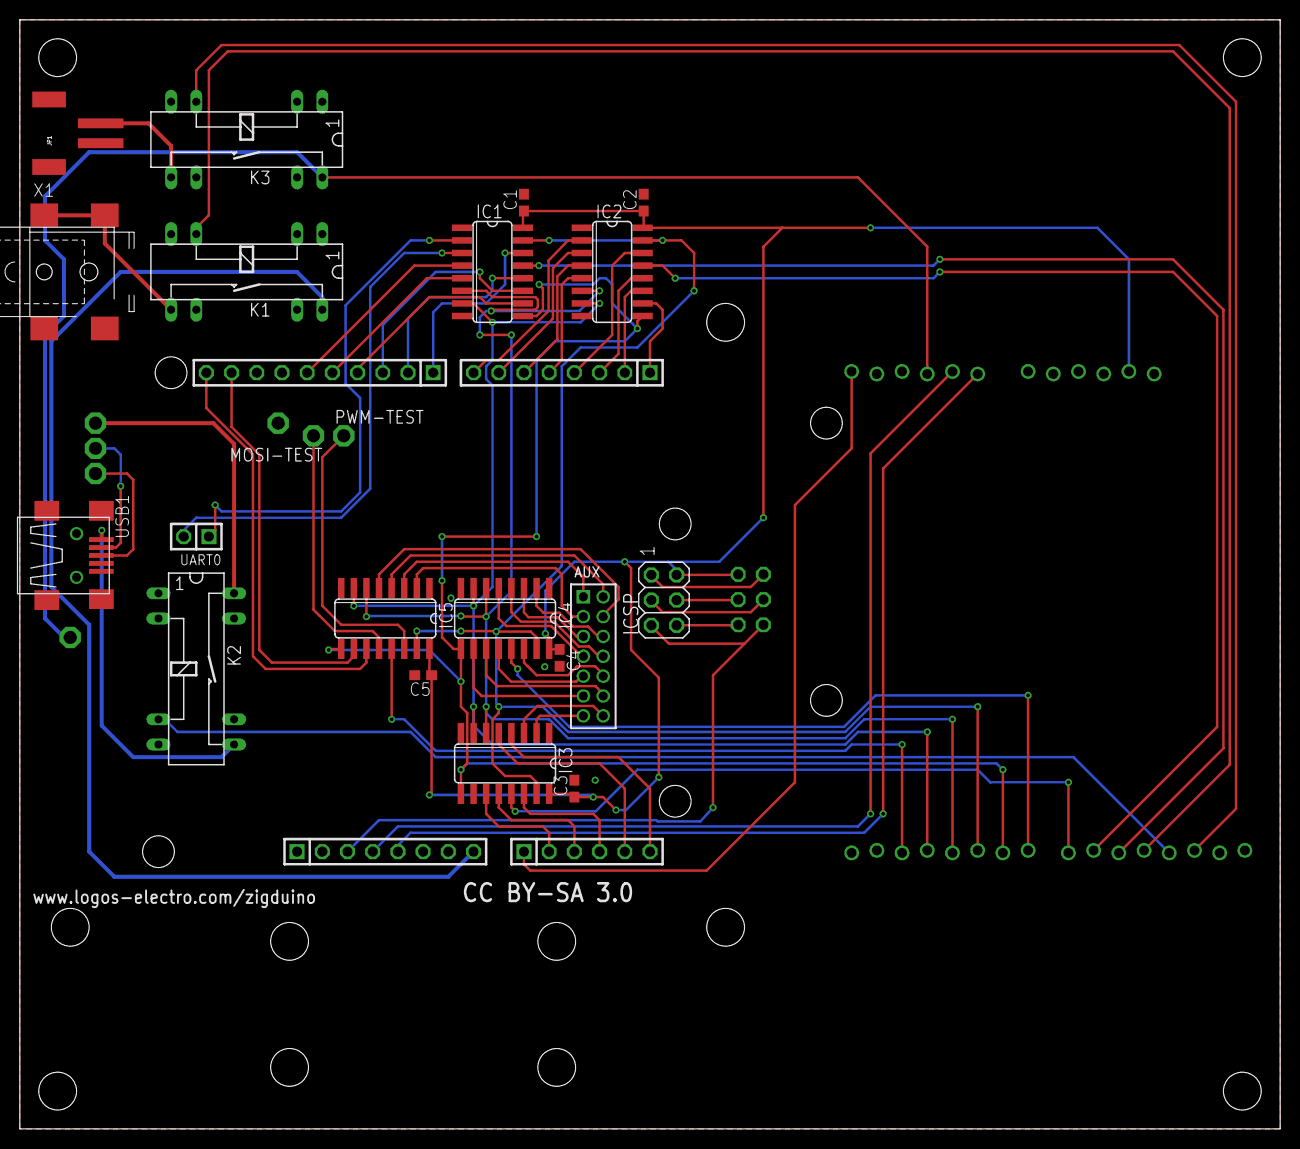
[picture p19: board zigduino-v6c-test.brd from above]

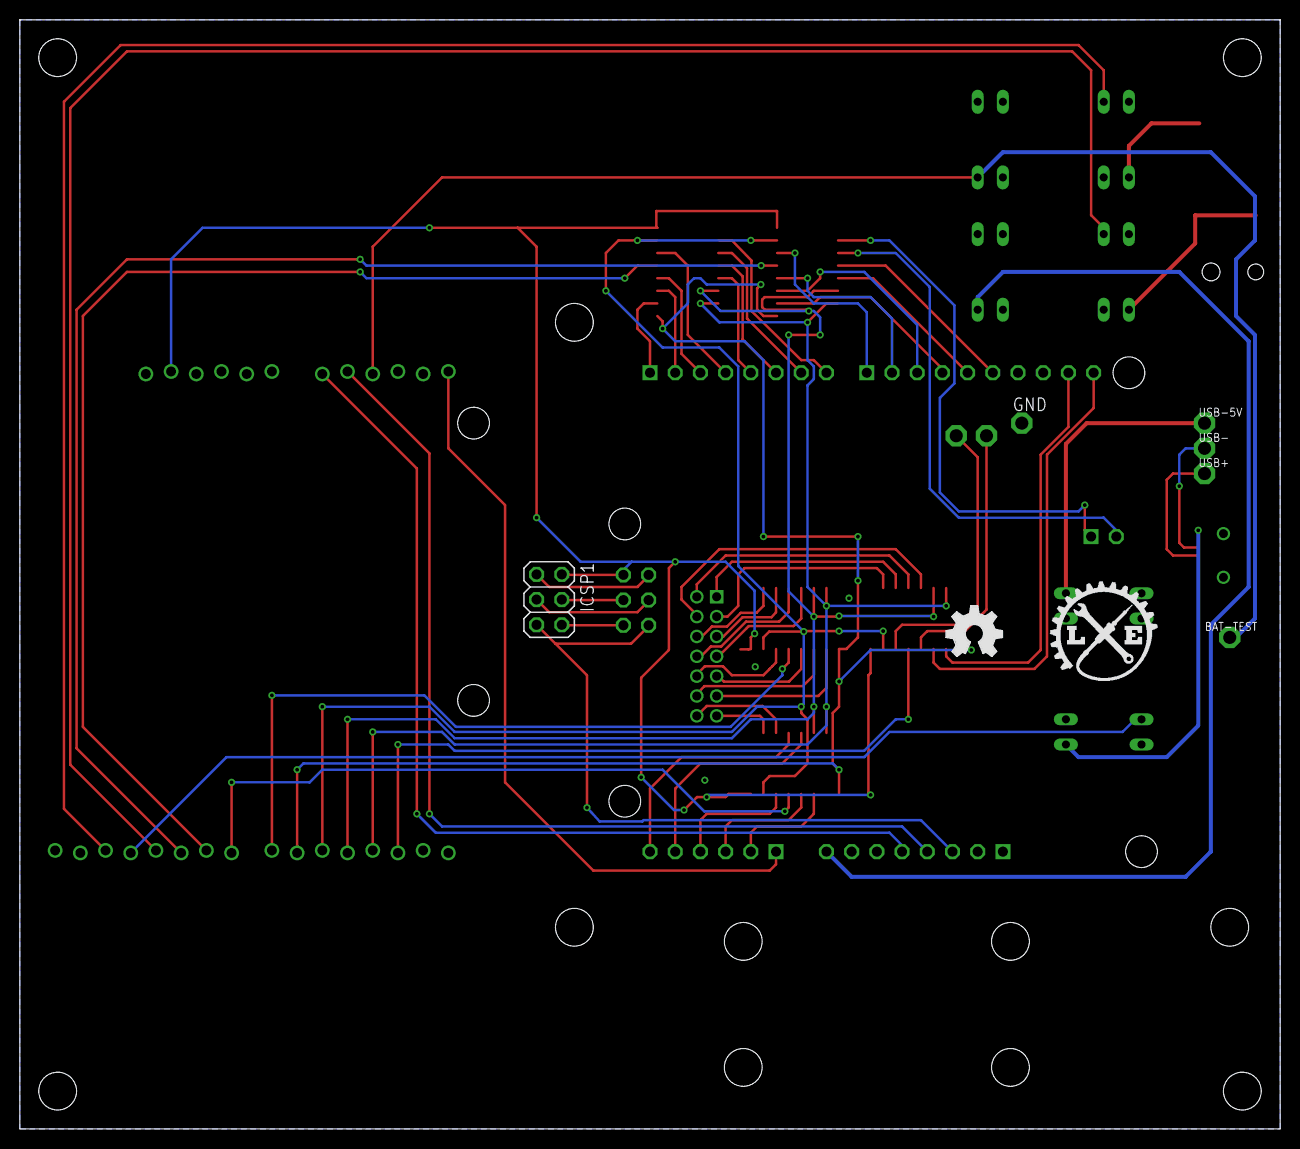
[picture p20: board zigduino-v6c-test.brd from below]

Board: 2 copper layers, 127.0 x 111.8 mm, 34 parts (8 on the bottom side), 68 nets.

Other parts of the board:
U$4: LOGO-SM
