logos-electromechanical/Zigduino-Hardware/(commit log)

2013-02-24 Checking in all of the current Zigduino files to the new repository.
    [Zigduino-v5a-panel.gbl, Zigduino-v5a-panel.gbo, Zigduino-v5a-panel.gbs, Zigduino-v5a-panel.gtl, Zigduino-v5a-panel.gto, Zigduino-v5a-panel.gts, Zigduino-v5a-panel.toollist.drl, Zigduino-v5b-panel.gbl]
2013-02-24 Checking in existing Zigduino Mote work
    [zigduino-mini-1.brd, zigduino-mini-1.sch, zigduino-mini-2.brd, zigduino-mini-2.sch, zigduino-mini-3.brd, zigduino-mini-3.sch]
2013-02-27 -- Checking in v6d files (aka Zigduino r2, spin 2) files -- Starting Esplora directory
    [zigduino-v6d.brd, zigduino-v6d.sch]
2013-06-12 Moved things around to create the Zigduino Micro
    [zigduino-mini-1.brd, zigduino-mini-1.sch, zigduino-mini-2.brd, zigduino-mini-2.sch, zigduino-mini-3.brd, zigduino-mini-3.sch]
2013-06-16 -- Changed .gitignore to ignore various generated files -- Created Zigduino Micro
    [zigduino-micro-1.brd, zigduino-micro-1.sch, zigduino-v6d.brd, zigduino-v6d.sch, zigduino-v6d_GenericPartsOrder.csv]
2013-12-27 added Zigduino Micro files updated burning instructions added Zigduino r3 files
    [zigduino-micro-2.brd, zigduino-micro-2.sch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]
