logos-electromechanical/Zigduino-Hardware/(notices)

Notices in the files:
Main/zigduino-v6d.brd:
(c) 2012 CC-BY-SA-3.0
parts and their libraries:
SparkFun: Licensing: CC v3.0 Share-Alike You are welcome to use this library for commercial purposes.
dicons: Copyright (C) 2004, Bob Starr (rtzaudio@mindspring.com)
